CoderDojoMusashikosugi/cub_2026_timing_sync_if_board/plan/design.md

# GPSタイミング同期インターフェース基板 設計書

- 文書状態: 初回試作を2026-09-06に発注し、2026-10から実機で試験中 / 機構条件と実機検証結果待ち
- 更新日: 2026-10-17
- 文書版: 0.38
- 発注版の基板: 回路図・PCB図・BOMは[`../hardware/rev1/`](../hardware/rev1/)。外形・層数・テストパッドの面は本書の当初の設計値と違う（§7）
- 製造先: JLCPCB PCBA
- EDA: EasyEDA Pro
- 文書種別: 最終設計の正本。検討経緯は[`considerations.md`](./considerations.md)、現在の未解決事項は[`../hardware/overall/open_issues.md`](../hardware/overall/open_issues.md)に分離する
- 最新clock部品選定: [`../hardware/reviews/oi010_tcxo_selection.md`](../hardware/reviews/oi010_tcxo_selection.md)（U2/U14はDR-050、bias値はDR-053）
- メーカー一次資料: [`../hardware/datasheets/`](../hardware/datasheets/)

## 1. 目的

外部UM982モジュールを基準時刻源とし、PPSおよびNMEA時刻情報をJetson Orin Nano、VLP-32C、Mid-360、Spresense向けレベルシフト基板へ配信する。GNSS信号消失時はJetson、さらにJetsonが使用できない場合はYXC `OW7EL89CENUYO3YLC-24M` / C22434890の24 MHz TCXOをU14 comparatorでCMOS化したclockでholdoverし、CR2032で保持したSTM32内蔵RTCの暦を使ってPPS/NMEAの出力を継続する。

## 2. 確定要求

| ID | 要求 | 状態 |
|---|---|---|
| R-001 | UM982のPPS/NMEAを各接続機器へ配信する | 確定 |
| R-002 | VLP-32C向けUART信号は論理反転する | 確定 |
| R-003 | VLP-32C向けNMEAの時刻は、元の時刻に対して1秒進める | 確定 |
| R-004 | GNSS信号消失時、MCUからPPS/NMEAを出力できる | 確定 |
| R-005 | JLCPCB PCBAを使用し、低コストを優先する | 確定 |
| R-006 | Basic Parts / Promotional Partsを可能な限り優先する | 確定 |
| R-007 | UM982は外部モジュールとし、GHコネクタ経由でPPS/NMEAを入力する | 確定 |
| R-008 | Jetson Orin Nano公式Developer Kitの40-pin headerへ、別の中継基板を経由して接続する | 確定 |
| R-009 | Spresenseのレベルシフトは別基板で行い、本基板のスコープ外とする | 確定 |
| R-010 | Jetsonからデバッグ用時刻を受信し、基板時刻とRTCを初期化できる | 確定 |
| R-011 | 時刻源の優先順位をGNSS、Jetson、RTCの順とする | 確定 |
| R-012 | Jetsonがなくても妥当な日時で起動できるよう、バックアップ電源付きRTCを搭載する | 確定 |
| R-013 | GNSS消失後5分間の時刻誤差を1 ms以下とする | 確定 |
| R-014 | 基板電源はUSB Type-Cから供給する | 確定 |
| R-015 | USB Type-CをMCUのデバッグコンソールおよびファームウェア更新にも使用する | 確定 |
| R-016 | 外部UM982へ本基板から給電しない | 確定 |
| R-017 | Jetson、VLP-32C、Mid-360、Spresense向けTXをMCUから個別に制御する | 確定 |
| R-018 | MCUの個別UART TX/RXおよびPPSを配線した予備GHコネクタを2個設ける | 確定 |

## 3. インターフェース仕様

### 3.1 UM982

- 電源は3.0～3.6 V、標準3.3 V。代表動作電流180 mA、最大300 mA。
- I/Oは3.3 V系。出力条件は2 mA時にLow最大0.45 V、High最小 `VCC - 0.45 V`。
- 3 UARTと1 PPSを持つ。
- UM982自体は本基板へ実装せず、外部モジュールからPPS/NMEA/GNDをGHコネクタで受ける。
- 現在の前提ではUM982への電源供給は行わない。給電も必要な場合はコネクタと電源回路を変更する。

資料: [UM982 User Manual R1.7](https://www.unicorecomm.com/assets/UM982_User_Manual_R1.7/index.html)

### 3.2 VLP-32C

- GPS入力はPPSと、NMEA GPRMCまたはGPGGAを使用する。
- 入力Highは3.0 V超～5.0 V未満、Lowは1.2 V未満。High時に2 mA以上を供給できること。
- UARTから直接出した通常極性ではなく、反転したシリアル信号を要求する。
- NMEA完了から次のPPS立上りまで300 ms以上、PPS立下りから次のNMEA開始まで50 ms以上が必要。
- したがって、VLP-32C向けNMEAは次のPPSに対応するUTC時刻へ+1秒し、チェックサムも再計算する。

資料: [VLP-32C User Manual](https://data.ouster.io/downloads/velodyne/user-manual/vlp-32c-revd-user-manual.pdf)

### 3.3 Mid-360

- PPSとGPRMC/GNRMCによるGPS同期に対応する。
- UART同期時は3.3 V TTLを使用し、PPSはMid-360のpin 8、GPS UART入力はpin 10。
- UARTは9600 baud、8 data bits、no parity。GPRMCまたはGNRMCを含める。
- PPS立上り後0～900 msにNMEA送信開始、推奨は0～430 ms。PPS High幅は10～200 ms推奨。
- PPSの立上りスルーレートは1 V/us超を推奨。

資料: [Livox Mid-360 Time Synchronization Instructions](https://livox-wiki-en.readthedocs.io/en/latest/tutorials/new_product/common/time_sync.html)

### 3.4 Jetson Orin Nano

- J3は別の中継基板へ接続し、中継基板が公式Developer Kit (P3768 carrier) の40-pin expansion headerへ配線する。どのheader pinへつなぐかは中継基板の範囲とし、本書では定めない（DR-062）。
- J3は出力専用とし、pin 2からPPS、pin 3からNMEA（GPRMC、9600 baud、8N1。§4.2）を出す。全信号は3.3 V系。J3 pin 4の受信回路は残るが運用では使わない（DR-061）。
- 時刻設定・状態確認の双方向通信はUSB（J1）のCDC interface 2で行う。CRC付きframe仕様は[`../hardware/overall/jetson_time_protocol.md`](../hardware/overall/jetson_time_protocol.md)を正とする（DR-061）。
- 参考: 2026-10時点のCub_ROS（Cub4）では、Jetson側はPPSをpin 32（GPIO07、`/dev/pps1`）、NMEAをpin 10（`/dev/ttyTHS1`、9600 baud）でNTPsecへ入れる設定である（Cub_ROS `scripts/install_host_settings.sh`）。

資料: [Jetson Orin Nano Developer Kit Carrier Board Specification](https://developer.nvidia.com/downloads/assets/embedded/secure/jetson/orin_nano/docs/jetson_orin_nano_devkit_carrier_board_specification_sp.pdf)

### 3.5 Spresense

- Spresense main boardのUARTは1.8 Vであるため、レベル変換は別プロジェクトの基板で行う。
- 本基板は外部レベルシフト基板へ3.3 V PPS/NMEA/GNDを出力する。Spresense本体へ直接接続しない。

資料: [Spresense Hardware Documents](https://developer.spresense.sony-semicon.com/development-guides/?lang=en&page=hw_docs)

## 4. システム構成

```mermaid
flowchart LR
    UM[UM982] -->|reference PPS| MCU[MCU timer + DPLL/holdover]
    USB[USB Type-C power + USB 2.0] --> MCU
    TCXO[YXC C22434890 24 MHz clipped sine] --> CMP[TI C544337 CMOS comparator]
    CMP -->|R8 / HSE bypass / timer clock| MCU
    LSE[LSE crystal + CR2032] -->|internal RTC / calendar| MCU
    UM -->|NMEA UART| MCU
    MCU -->|continuous generated PPS| FAN[PPS fanout / output buffers]
    FAN --> JET[Jetson]
    FAN --> VLP[VLP-32C]
    FAN --> MID[Mid-360]
    FAN --> SPR[Spresense]
    JET <-->|USB CDC: time set / status| USB
    MCU -->|dedicated UART| JBUF[Jetson output buffer]
    JBUF --> JET
    MCU -->|dedicated UART| MBUF[Mid output buffer]
    MBUF --> MID
    MCU -->|dedicated UART| SBUF[Spresense output buffer]
    SBUF --> SPR
    MCU -->|UTC + 1 s, checksum recomputed / TXINV| INV[3.3 V VLP buffer]
    INV --> VLP
```

### 4.1 PPS経路

- 出力PPSはGNSS正常時を含め、常にMCUのハードウェアタイマー出力比較機能で生成する。GNSS PPSは出力源として直接切り替えず、MCUタイマーを規律する基準として使用する。
- 生成PPSとGNSS PPSキャプチャは32-bitのTIM2へ集約する。生成PPSはPC5/TIM2_CH2、GNSS PPSキャプチャはPA5/TIM2_CH1を使用し、CH3のpinは未使用とする（firmwareはCH3/CH4をpinなしの比較割込みに使う）。16-bitのTIM3は1 Hz生成に必要な分解能が不足するため使用しない。詳細は[`../hardware/overall/pin_assignment.md`](../hardware/overall/pin_assignment.md)の「PPS/holdoverのtimer構成」を正とする。
- MCUはGNSS PPSをタイマー入力キャプチャで監視し、位相誤差と周波数誤差を推定する。GNSS PPSはU4A `SN74LV14A`で反転するため立下りedgeでキャプチャする。
- GNSS異常時はPPS生成を継続し、GNSS有効中に学習した24 MHz TCXOの周波数補正値を保持する。TCXOはTIM2のクロック源そのものなので、外部RTCとの周波数比計測は不要である。
- U2はYXC `OW7EL89CENUYO3YLC-24M` / C22434890を採用する。3.3 V、clipped sine 0.8 Vp-p min、10 kOhm // 10 pF、-30～85 ℃で温度安定度±1.5 ppm、消費電流2.0 mA maxである。C11でAC結合して1.031 Vへbiasし、U14 TI `LMV7219M7X/NOPB` / C544337で3.3 V CMOS化する。U14 OUTをR8経由でPF0/OSC_INへ入力し、STM32はHSE bypass mode、PF1/OSC_OUTは未接続とする。PF0入力は24 MHz、duty 45～55 %を満たすことを試作合否条件とする。
- GNSS復帰時は正常なPPS/NMEAを5回以上連続受信してから再同期を開始する。出力PPS周期の補正量を1秒当たり±100 usに制限し、PPS間隔を0.999900～1.000100秒の範囲で緩やかにGNSS位相へ戻す。
- 再同期中も短パルス、二重パルス、パルス欠落、秒の重複・飛越を発生させない。位相差が通常のslewで安全に回復できないほど大きい場合は、次のとおり扱う（DR-061）。holdover中の時刻がGNSS由来なら、位相差100 ms超または秒の不一致で`FAULT`（全出力High-Z）とする。RTCまたはJetson由来なら、1 ms超または秒の不一致で出力をHigh-Zにしてstepし、2秒正常が続いてから出力を戻す。詳細は[`../hardware/overall/time_source_state_machine.md`](../hardware/overall/time_source_state_machine.md)「GNSS復帰時の合わせ方」。
- 各PPS出力には個別の直列抵抗を設ける。測定は原則として各コネクタpin 2とpin 1 GNDから行い、信号測定用の恒久テストパッドは生成源`PPS_GENERATED`のTP6、VLP負荷試験用TP7/TP8、PA6の汎用firmware trace用TP9だけとする。初回プロトタイプではGH信号ESD footprint自体を設けず、同一ロボット内・電源OFF中のみ接続という運用条件を適用する。

#### 4.1.1 GNSS PPSに対する遅延・位相差

- 現構成は、受信したGNSS PPSの同じedgeを遅延させて出力するrepeaterではない。DPLLで次の秒境界を予測し、MCU timerが出力PPSを生成する。
- したがって定常時に管理する値は「入力から出力までの因果的な伝搬遅延」ではなく、「GNSS PPSと生成PPSの位相差」とする。
- GNSS入力はU4A `SN74LV14A`を通るため信号が反転する。3.3 V・CL=15 pFでの伝搬遅延は最大15 ns（-40～85 ℃）であり、固定offsetは出力74LVC125Aと合わせて実測・校正する。
- 入力側の固定遅延にはR13 4.7 kOhm、U4A入力容量2.3 pF、配線・source容量、U4A伝搬遅延、capture同期遅延が含まれる。旧74HC14を前提にした55～82 ns/基板間差27 nsの概算は使用せず、実装後の測定値をDPLL位相補正へ含める。
- STM32G0B1で32-bitのTIM2を48 MHzで動作させた場合の1 tickは約20.833 ns。ARR=47,999,999で1秒周期とし、周期補正の1 LSBは約0.0208 ppmとなる。入力capture同期遅延を含む固定offsetは、実装後に測定してDPLLの位相補正値へ含める。
- timer output compareでedgeを生成するため、通常のfirmware割込み応答時間はPPS edgeのジッタへ直接加算されない。
- 設計目標は、GNSS追従安定後の基板コネクタ出力edgeをGNSS入力edgeに対して絶対値1 us以内とする。保証可否は基準クロック構成と実機測定後に判定する。
- 電源投入後は、最初に生成PPSをGNSS PPSへstepで揃えてから、位相差1 us以内のGNSS PPS/NMEAを5回連続確認してPPSを有効化する。屋外の実測では、PPSとRMC=`A`がそろってから約8秒だった。GNSS復帰時は、slewで戻せる範囲（§4.1）なら既存PPSを停止せず、±100 us/秒以内で位相を戻す。
- ケーブルの伝搬時間は基板コネクタより後段の遅延として別管理する。接続先での同期精度を規定する場合はケーブル長差も校正対象とする。

### 4.2 NMEA経路

- UM982のNMEAをMCUで受信し、構文、UTC、valid flag、チェックサムを検証する。
- Jetson、Mid-360、Spresense、VLP-32C、予備1、予備2はそれぞれ別のMCU UART/LPUART TXへ割り当てる。TX線同士を電気的に分岐せず、送信内容、baud rate、送信開始時刻、出力enableを個別に制御する。
- Mid-360とSpresenseへは当初同じGPRMC/GNRMCを9600 baud / 8N1 / 1 Hzで送るが、ファームウェア上は独立した送信queueを持たせる。
- VLP-32C系はUTCを1秒加算し、23:59:59の日付繰上げも処理してチェックサムを再計算した後、論理反転して出力する。
- GNSS異常時は保持時刻を同じ出力経路へ載せ、RMCのstatusは無効（`V`）とする。保持中の時刻継続とGNSS測位有効性を混同させない。
- VLP-32C/Mid-360がRMC=`V`で内部同期を維持することはメーカー資料で保証されない。試作ではPPS/RMC=`V`を継続し、各LiDARのtimestamp追従を統合試験する。`A`を偽装しない。

### 4.3 電源

- 入力VBUSはUSB規定内の4.75～5.25 Vとする。MCU、U2 TCXO、U14 comparator、全出力bufferは3.3 Vとし、TCXO専用LDOは設けない。VLP専用電源も設けない。
- USB Type-CのVBUS 5 Vだけを主電源とする。Jetson用GHおよび他の信号コネクタからは給電しない。
- USB Type-CはUSB 2.0 device/UFPとして構成し、CC1/CC2へ各5.1 kOhmのRdを接続する。USB PDは実装しない。
- VBUSの500 mA級リセッタブルヒューズF1は低予算初回ではDNPとし、F1と並列のR3 `0603WAF0000T5E` / C21189を実装してVBUSを導通させる。D1はPromotionalの単方向TVS `SMF6.0A` / C19077499を初回から実装し、pin 1(K)を`VBUS_PROTECTED`、pin 2(A)をGNDへ接続する。保護variantではR3をDNP、F1を実装し、F1/R3の同時実装は禁止する。D1はVRWM 6 V、VBR 6.67～7.37 V、VC max 10.3 VのESD・短時間transient対策であり、継続的な過電圧を遮断するOVPではない。
- 外部機器へ給電しない。通常構成の基板消費電流はUSB 2.0未configured時の100 mA未満を合否基準とする。
- VBUS配線・R3・F1の物理設計上限は0.5 Aとするが、これは通常消費の許容値ではない。電流内訳、U3損失、VBAT寿命は[`../hardware/overall/power_budget.md`](../hardware/overall/power_budget.md)を正とする。
- CR2032からR4=100 Ohmを介してSTM32のVBATへ接続し、LSEと内蔵RTCにより主電源断中も暦とbackup registerを保持する。充電経路は設けない。
- 外部UM982、LiDAR、Jetson、Spresenseへは原則として給電せず、信号と共通GNDだけを接続する。
- 初回試作では追加のpower sense/isolationを実装しない。J2～J8は全機器OFF中に接続・切断し、本基板を外部入力源より先または同時にONする。接続先OFF前に全出力`OE_N`をHighとしてHigh-Zへ移行する。詳細は[`../hardware/overall/pin_assignment.md`](../hardware/overall/pin_assignment.md)の「試作機の電源順序制約」を正とする。

### 4.4 時刻源の優先順位と更新

| 優先度 | 時刻源 | 有効条件 | 動作 |
|---:|---|---|---|
| 1 | GNSS | 正常なPPSと検証済みNMEAを継続受信 | TCXO/TIM2 PPSをGNSSへ規律し、MCU時刻と内蔵RTCを更新 |
| 2 | Jetson | GNSS無効かつJetsonから有効な時刻設定/更新を受信 | MCU時刻と内蔵RTCを更新し、TCXO/TIM2生成PPS/NMEAを使用 |
| 3 | 内蔵RTC + TCXO holdover | GNSSとJetsonが無効 | 内蔵RTCの暦とTCXO/TIM2の秒間隔でPPS/NMEAを使用 |

- Jetsonの一回限りのSETコマンドはRTC初期化として扱う。
- Jetsonを継続時刻源として扱う場合は、時刻更新の有効期限を設け、timeout後はRTCへ戻る。（現在のfirmwareには有効期限がない。[`../firmware/test_plan.md`](../firmware/test_plan.md) P-13）
- GNSS有効中はJetsonからのSETを拒否するか、RTCを変更せずデバッグ応答だけを返す。（現在のfirmwareは`NACK_GNSS_ACTIVE`で拒否する）
- 現在使用中の時刻源、最終同期時刻、PPS/NMEA状態、RTC有効性をJetsonから取得できるプロトコルを定義する。現在のfirmwareの`TIME_STATUS`が返すのは、UTC、state、flags（RTC有効、GNSS有効、clock fault、LSE ready）、最後に適用したSETのsource_id/sequence、last errorである。時刻源、最終同期時刻、出力のenable状態は返さず、consoleの`status`でだけ見られる。RTC有効性は使用する全backup registerのsignature/versionとpayload CRC、RTC-domain configuration CRC、`INITS`、RTCSEL/LSEON/LSERDY/RTCEN、calendar範囲、SSR単調性で判定し、VBAT電圧の実測値とはしない。`RTC_VALID`は起動時の整合性だけを示し、主電源断中のLSE連続動作や電池残量は保証しない。
- 内蔵RTC/LSEの起動判定、Jetson SETのstep/slew、GNSS復帰、clock fault処理の正本は[`../hardware/overall/time_source_state_machine.md`](../hardware/overall/time_source_state_machine.md)とする。

### 4.5 USBデバッグインターフェース

- MCUのnative USB Full-Speed deviceをUSB Type-CのD+/D-へ接続する。
- 通常動作時はUSB CDC ACMを2つ実装する。interface 0はconsoleとしてログ表示、状態取得、テスト出力制御に使い、interface 2はJetsonとの時刻protocol（§3.4）に使う。
- 内蔵system bootloaderのUSB DFUでファームウェアを書き込めるよう、BOOT操作とRESET操作を基板上で可能にする。
- ファームウェア異常時のsource-level debugに備え、SWDIO、SWCLK、NRST、3V3、GNDのテストパッドを残す。
- PA6には唯一の汎用firmware event traceとしてTP9 `TP_FW_TRACE`を残す。SWOではなくGPIO pulse観測用とし、通常firmwareではanalog/no-pull、明示的なdebug buildまたは設定時だけ既定LowのGPIO出力として有効化する。製品機能はTP9へ依存させない。
- D+/D-はU11 `USBLC6-2SC6`で保護し、差動配線を短く等長にする。発注版に直列抵抗はない（U11とMCUを直結）。
- SW1 RESETとSW2 BOOTには小型Basic `TS-1088-AR02016` / C720477を使用する。PA15の専用DFU buttonおよび予備test padは設けずNCとし、正常時はUSB CDC command、異常時はBOOT+RESETでDFUへ入る設計である。
- PA14-BOOT0は100 kOhm pull-down、BOOT switch側は1 kOhm seriesとする。NRSTは10 kOhm pull-up、100 nF to GNDとする。
- 外部BOOT0を使うoption byte（`nBOOT_SEL=0`）は、試験中の2枚では設定していない（出荷時のまま）。このためSW2+SW1ではDFUに入れず、DFUへはconsoleの`dfu` commandで移る。未書込みの基板はUSBをつなぐだけでDFUになる。option byteを設定するかは判断待ちである（[`../firmware/test_plan.md`](../firmware/test_plan.md) P-22）。
- SWD debug接続後にBOOT+RESETでDFUへ入る場合は、STM32G0B1 errata ES0548 §2.2.8に従い、probeを外してUSBを含む全主電源を完全power cycleしてから操作する。

### 4.6 GH互換コネクタ割当

基板側はGH互換のCJT A1257シリーズ 1.25 mm pitch横型SMTヘッダとし、3 pinは`A1257WR-S-3P` / `C225126`、4 pinは`A1257WR-S-4P` / `C225127`を採用する。相手側は`A1257H-3P` / `A1257H-4P`、圧着端子は`A1257-TP`へ統一する。誤挿入を避けるため、信号コネクタのpin 1はすべてGNDとする。選定根拠は[`../hardware/reviews/gh_connector_selection.md`](../hardware/reviews/gh_connector_selection.md)に保存する。

| Ref | 接続先 | 極数 | pin assignment |
|---|---|---:|---|
| J1 | USB Type-C | USB2 Type-C | VBUS, GND, `USB_DP_CONN`, `USB_DN_CONN`, CC1, CC2 |
| J2 | 外部UM982 | 3 | 1:GND, 2:`GNSS_PPS_IN`, 3:`GNSS_NMEA_RX_IN` |
| J3 | Jetson（中継基板経由） | 4 | 1:GND, 2:`JETSON_PPS_OUT`, 3:`JETSON_TX_OUT`, 4:`JETSON_RX_IN` |
| J4 | VLP-32C | 3 | 1:GND, 2:`VLP_PPS_OUT`, 3:`VLP_TX_OUT` |
| J5 | Mid-360 | 3 | 1:GND, 2:`MID360_PPS_OUT`, 3:`MID360_TX_OUT` |
| J6 | Spresense IMU用レベルシフト基板 | 3 | 1:GND, 2:`IMU_PPS_OUT`, 3:`IMU_TX_OUT` |
| J7 | 予備UART 1 | 4 | 1:GND, 2:`AUX1_PPS_OUT`, 3:`AUX1_TX_OUT`, 4:`AUX1_RX_IN` |
| J8 | 予備UART 2 | 4 | 1:GND, 2:`AUX2_PPS_OUT`, 3:`AUX2_TX_OUT`, 4:`AUX2_RX_IN` |

J2/J3/J7/J8の入力ラベルは直列抵抗よりU4側に置き、コネクタから直列抵抗までの短い区間は無名netとする。USBはU11を境にコネクタ側`USB_DP_CONN`/`USB_DN_CONN`とMCU側`USB_DP`/`USB_DN`へ分割し、保護素子を経由する配線を固定する。

- J3の相手は別の中継基板とし、Jetson 40-pin headerへの配線とpin割当は中継基板で管理する（DR-062）。J3 pin 4は運用では使わない（§3.4）。
- 本基板をJetson側40-pin headerへ直接搭載しない。中継基板とはGHケーブルで接続する。
- J7/J8は3.3 V UART専用とし、電源pinを設けない。外部機器への給電が必要になった場合は別コネクタまたは別基板で対応する。
- J2～J8はCJT A1257シリーズをJLCPCBでPCBA実装する（初回試作はこの構成で実装した）。
- 相手機器側connector/pin、使用UART、線色、線長はTBDとし、試作ハーネス製作前に[`../hardware/overall/harness_pinout.md`](../hardware/overall/harness_pinout.md)のTODOと導通検査表を完成させる。TBDを推測で埋めない。

## 5. 信号表

| 接続先 | PPS | NMEA | 電気レベル | 固有処理 | 状態 |
|---|---:|---:|---|---|---|
| Jetson Orin Nano（中継基板経由） | 1 | 1 | 3.3 V | J3は出力専用。時刻設定・状態確認はUSB CDC interface 2 | 基本仕様確定 |
| VLP-32C | 1 | 1 | 3.3 V試作出力 | NMEA +1秒、UART反転。High >3.0 V @ 2 mAはJ4実測で合否判定 | 機能・GH互換3 pin確定、電圧は試作検証 |
| Mid-360 | 1 | 1 | 3.3 V TTL | 9600 8N1、GPRMC/GNRMC | 電気仕様・GH互換3 pin確定 |
| Spresense IMU用レベルシフト基板 | 1 | 1 | 3.3 V | `IMU_*`はCXD5602PWBIMU1J向け系統名。レベル変換はスコープ外 | 基本仕様確定 |
| 予備UART 1 | 1 | 双方向UART 1 | 3.3 V | 独立TX/RX、給電なし | 確定 |
| 予備UART 2 | 1 | 双方向UART 1 | 3.3 V | 独立TX/RX、給電なし | 確定 |

## 6. MCUおよび主要回路

### 6.1 MCUへ割り当てる機能

- UM982受信用UART x1。
- Jetson、VLP-32C、Mid-360、Spresense、予備2系統の独立TX、合計6系統。
- Jetsonと予備2系統のRX、UM982受信用RX。Jetson RX（J3 pin 4）は運用では使わず、受信経路と折返しの試験（UA-01、UA-03）だけに使う（DR-061）。
- Jetsonとの時刻protocol用のUSB CDC（§4.5）。
- VLP-32C用UARTはUSARTの`TXINV`で反転する。
- PPS入力キャプチャとPPS生成を1個の32-bitタイマー（TIM2）の2チャネルで実現する。
- UTC日時処理、NMEA parser/checksum、ウォッチドッグ、brown-out reset。（現在のfirmwareはwatchdogを使っておらず、BORのoption byteも変更していない。P-14）
- J7/J8のRX（予備UARTの受信）は回路にはあるが、現在の製品firmwareでは使っていない。
- 製造時書込み用SWD等。
- 24 MHz HSE bypass、内蔵RTC/LSE、backup register、smooth calibrationを使用する。

### 6.1.1 クロック構成

基板にはU2 YXC `OW7EL89CENUYO3YLC-24M` / C22434890、U14 TI `LMV7219M7X/NOPB` / C544337、32.768 kHz LSE水晶を実装する。U2のclipped-sine出力はC11と1.031 V bias回路を経てU14で3.3 V CMOS化し、R8経由でHSE bypass/PLL/TIM2を駆動する。LSEはCR2032でバックアップされるSTM32内蔵RTC専用とする。旧C48677994/C51822852/C51966238は採用解除した。

clock初期化は電源投入後5 ms以上待ち、Voltage Range 1へ設定して`VOSF=0`を確認し、Flash latencyを2 wait stateへ上げた後にPLLM=2、PLLN=16、PLLR=4のPLLへSYSCLKを切り替える。PLLQ=4をUSBへ供給する。LSEは`LSEDRV=10`（medium-high）とし、VBAT保持と競合するSTM32G0B1 errata ES0548 §2.2.1を避けるため`LSECSSON=0`とする。

| 項目 | 構成 | 備考 |
|---|---|---|
| SYSCLK / timer clock源 | 24 MHz TCXO + comparator + HSE bypass + PLL、48 MHz | PLLM=2、PLLN=16、PLLR=4。PF0 duty 45～55 %、Voltage Range 1、Flash 2 wait state。TIM2も48 MHz |
| timer clockの周波数基準 | **YXC OW7EL89CENUYO3YLC-24M / C22434890、温度安定度±1.5 ppm** | GNSS有効中に実測補正値を学習し、holdoverで保持する。U14の固定delayは周波数へ累積しない。R-013は試作実測で判定する |
| UTCの絶対基準 | GNSS PPS + 検証済みNMEA | GNSS有効中はDPLLで位相・周波数を規律する |
| USB clock | PLLQ=48 MHz | PLLM=2、PLLN=16、PLLQ=4。HSI48+CRSは使用しない |
| UART baud生成 | TCXO/PLL由来 | 温度安定度±1.5 ppm級であり、外部比率計測なしで十分なbaud精度を得る |
| RTC/calendar | STM32内蔵RTC + 32.768 kHz LSE + CR2032 | PC14/PC15に7 pF品を接続。`LSEDRV=10`、LSE CSS無効。電源断中はcalendar/backup registerを保持する |
| clock fault | HSE CSS + firmware監視 | HSE/PLL fault時はHSIへ退避するが、PPS/NMEAはHigh-Zとして`FAULT_CLOCK`へ遷移する |

以下の主要部品を採用し、初回試作に実装した。選定経緯は[`considerations.md`](./considerations.md)へ分離する。価格・在庫は2026-09-06の発注時点の値であり、次版の発注時に再確認する。

### 6.2 採用主要部品

| 機能 | 採用品 | LCSC | 選定理由 | 状態 |
|---|---|---|---|---|
| MCU | **STM32G0B1RCT6** | **C3034735** | native USB FS、6 USART + 2 LPUART、32-bit TIM2、LQFP-64、Flash 256 KB / SRAM 144 KB | **採用（DR-060、2026-09-06）。** 旧`STM32G0B1RBT6` / `C5143679`が在庫0となったため変更。2026-09-06確認時$3.0669、在庫173、予約可能104。**N接尾辞品`STM32G0B1RCT6N`はpin 40/41が非互換なので差し替え禁止** |
| TCXO | **YXC OW7EL89CENUYO3YLC-24M** | **C22434890** | 24 MHz、clipped sine 0.8 Vp-p min、±1.5 ppm、-30～85 ℃、2.0 mA max、SMD2016-4P | **採用。** 通常SMT、在庫約6,500、$0.87前後。無断代替禁止 |
| Clock comparator | **TI LMV7219M7X/NOPB** | **C544337** | 2.7～5 V、push-pull、7 mV hysteresis、20 ns max delay、SC-70-5 | **採用。** API確認時在庫911、予約可能907、$0.8965 |
| LSE crystal | SC-32S32.768kHz20PPM7pF | C97604 | 32.768 kHz、CL=7 pF、±20 ppm、SMD3215 | 採用。内蔵RTC/calendar専用。2026-08-12 API価格$0.1886 |
| USB ESD | USBLC6-2SC6 | C7519 | USB 2.0対応2-line ESD保護 | 採用。D+/D-コネクタ直近へ実装 |

- U2はpin 1=NC、pin 2=GND、pin 3=OUT、pin 4=`3V3`。U14はpin 1=OUT、2=GND、3=+IN、4=-IN、5=`3V3`とする。C11 AC結合、R5=33 kOhm/R6=15 kOhm/C12の1.031 V reference、R7 bias、C13 decouplingを実装し、U14 pin 1をR8=33 Ohm経由でPF0へ接続する。U15/`+2V8_CLK`は配置しない。
- C22434890は通常SMT、C544337はExtended/SMTである。DR-050時点の受動部品とclock直列Rを含むclock chainは約$1.8346だった。
- JLCPCBのBasic/Promotional区分は変動するため、次版の発注用BOM作成時に公式parts libraryで再確認する。
- STM32G0B1RCT6は[ST製品情報](https://www.st.com/en/microcontrollers-microprocessors/stm32g0b1rc.html)、データシート`STM32G0B1xB/xC/xE` DS13560 Rev 6および[JLCPCB C3034735](https://jlcpcb.com/partdetail/STMicroelectronics-STM32G0B1RCT6/C3034735)、U2/U14は[YXC YSO510TP family資料](https://www.yxc.hk/uploadfiles/2023/07/20230710175706329.pdf)と[TI LMV7219資料](https://www.ti.com/lit/ds/symlink/lmv7219.pdf)を参照。選定詳細は[`../hardware/reviews/oi010_tcxo_selection.md`](../hardware/reviews/oi010_tcxo_selection.md)を正とする。MCUの在庫切れ対応と代替検証は[`../hardware/reviews/mcu_stock_alternative_20260906.md`](../hardware/reviews/mcu_stock_alternative_20260906.md)を正とする。
- MCUの`_RB` / `_RC` / `_RE`はDS13560 Rev 6 Table 2で同一列にまとめられ、`VDDIO2 pin / VSS pin = No/No`、GPIO 60、USART 6、LPUART 2、USB 1、32-bit timer 1が共通である。差はFlash容量だけ（128 / 256 / 512 KB）でSRAMはいずれも144 KB。LQFP64のpinout図も1枚しかない。EasyEDAのpackageも旧新ともuuid `2afd511af2e94adea785d3da1efd72a1`（`LQFP-64_L10.0-W10.0-P0.50-LS12.0-BL`）で同一実体であり、**PCBのpad・配線・部品配置およびpin割当は変更しない。** firmware側はlinker scriptのFLASH容量と、Flash容量で変わるdual bankの境界・ページ番号（RM0444）だけ確認する。

### 6.3 MCUピン割当

`STM32G0B1RCT6` LQFP-64へ再割当済みであり、物理pin番号、alternate function、net、connector/buffer接続の正本は[`../hardware/overall/pin_assignment.md`](../hardware/overall/pin_assignment.md)とする。旧LQFP-48のpin番号は使用しない。

2026-08-11のDR-012で、物理pin番号をST CubeMX pin database（`STM32G0B1R(B-C-E)Tx.xml`、`Package="LQFP64"`）へ照合し全面修正した。**版0.20以前のpin番号表は使用してはならない。** GPIO名とAF番号は修正前から正しい。

- 6系統TXはUSART1/2/4/5/6およびLPUART2へ分離する。
- GNSS PPS captureはPA5/TIM2_CH1（物理pin 22）、生成PPSはPC5/TIM2_CH2（物理pin 26）を使用する。TIM3は16-bitで1 Hz生成に使えないため用途から外した。
- TCXO clockはPF0/OSC_IN（物理pin 10）へHSE bypass入力し、PF1/OSC_OUTは未接続とする。LSEはPC14/PC15（物理pin 4/5）へ接続する。PB10/TIM2_CH3は未使用とする。
- SC-32SのESR最大70 kOhm、C0 typ 1 pF、CL 7 pFから`gmcrit`は概算0.76 uA/Vであり、STM32のmedium-low最大0.75 uA/Vでは余裕がないためmedium-high（`LSEDRV=10`、最大1.7 uA/V）を固定使用する。
- USBはdefault mappingのPA11/PA12を使用し、PA9/PA10へのUSB remapは使用しない。
- **本パッケージの電源・基準pinはVBAT（6）、VREF+（7）、VDD（8）、VSS（9）の4本だけである。`VDDIO2`、`VDDA`、`VSSA`、`VDDUSB`のpinは存在しない。** pin 40/41はPD8/PD9であり、電源へ接続してはならない。
- `PPS_OE_N`はMCUが時刻源とtimer初期化を検証するまでHighに保持し、全PPS出力を無効にする。
- PA14はSWCLKとBOOT0を兼ねるため、通常動作を妨げない抵抗構成でBOOT操作する。

### 6.4 ロジック回路の採用構成

| ブロック | 構成 | 設計意図 |
|---|---|---|
| 外部入力 | TI `SN74LV14ADR` / C475503 hex inverting Schmitt x1 | GNSS PPS/NMEA、Jetson、予備UART x2の5入力を集約。UART `RXINV`とtimer edge極性で反転補償。GNSS PPSは100 kOhm pull-down、UART RXは100 kOhm pull-up |
| 3.3 V PPS/UART出力 | 74LVC125A quad buffer x3 | J3～J8の12出力を個別駆動・個別enable。U7C/U7DはVLP PPS/NMEAを担当 |
| VLP PPS/NMEA出力 | U7C/U7D `74LVC125A` | 3.3 V試作出力。High >3.0 V @ 2 mAは1.5 kOhm負荷とVLP実機で検証 |
| VLP反転 | STM32 USART `TXINV` + U7D | VLP-32C要求の反転UARTをMCU内で生成。専用電源・level driverは使用しない |

出力bufferはU7=J3/J4、U8=J5/J6、U12=J7/J8を担当し、すべて3.3 Vで駆動する。PPSは入力netだけを共通化し、6出力は個別buffer出力とする。channel、net、`/OE`、connector pinの完全な対応は[`../hardware/overall/pin_assignment.md`](../hardware/overall/pin_assignment.md)を正とする。

- U4 `SN74LV14A`は`Ioff`に対応し、VCC=0 V時の部分給電防止を規定している。4.7 kOhm直列抵抗と100 kOhm biasは入力保護・未接続時状態固定のため維持する。コネクタ側機器を含むシステム全体のhot-plug可否は別途評価し、U4単体の`Ioff`だけを根拠に無条件許可しない。
- `SN74LV14A`はVCC=3.3 VでVT+ max 2.31 V、VT- min 0.99 V、hysteresis min 0.33 Vを規定する。GNSS PPSの100 kOhm pull-down回路は外部High=2.85 V/Low=0.45 Vの保守条件でU4入力約2.72 V/0.43 V、UARTの100 kOhm pull-up回路は約2.87 V/0.58 Vとなり、保証しきい値に対して成立する。
- GHコネクタ直前の出力には33 Ohm初期値の直列抵抗を置く。**VLP出力の2 netだけは10 Ohmとする。** High >3.0 V @ 2 mAは、規定されていない条件を他の試験点から補間して保証値とみなさず、1.5 kOhm負荷とVLP実機で実力判定する。不合格の場合は次版で専用level driverを追加する。
- GH信号ESD footprintは初回基板から削除する。ノイズまたはESD問題が再現した場合は次版で必要なnetだけ再設計する。
- PPS source selectorは不要とし、MCUタイマー出力だけをPPS分配bufferへ入力する。GNSS復帰時の連続性はtimer/DPLL制御で確保する。

### 6.5 電源・USB回路の採用構成

| ブロック | 採用品 | 方針 |
|---|---|---|
| USB Type-C receptacle | TYPE-C-31-M-12相当、LCSC C165948 | USB 2.0 device、16 pin、CC1/CC2へ各5.1 kOhm Rd |
| 3.3 V LDO | TI `TPS70933DBVR`、LCSC C89347 | 逆電流保護内蔵、150 mA連続・200 mA peak、入力2.7～30 V、3.3 V固定、SOT-23-5。pin 1=IN、2=GND、3=EN、4=NC、5=OUT。IN/EN=`VBUS_PROTECTED`、OUT=`3V3`。3.3 V rail設計上限100 mA（DR-059） |
| USB ESD | USBLC6-2SC6、LCSC C7519 | D+/D-をコネクタ直近で保護 |
| VBUS保護 | F1 `MF-NSMF050-2` + R3 `0603WAF0000T5E` / C21189 + D1 `SMF6.0A` / C19077499 | 初回はF1 DNP、R3/D1実装。保護variantはF1/D1実装、R3 DNP。D1はPromotionalの単方向TVSでESD・短時間surge用。5 V規定USB電源のみ使用 |
| RTC backup | CR2032一次電池 + holder + R4 100 Ohm | 充電回路は設けず、BT1 pin 2（+）からR4を介してSTM32 VBATへ接続。pin 1（-）はGND（DR-058確認済み） |

- MCUのVDD/VDDAとVREF+は`3V3`へ接続し、VBATだけをCR2032由来の`VBAT_RTC`へ接続する。各電源pin直近へ100 nFを置く。VDDAはパッケージ内部でVDDへ結線されるため専用railは不要であり、旧`+3V3_A` netは廃止する。VREF+は`3V3`直結とし、VREFBUFは有効化しない。
- VBUS側bulkはC1=4.7 uF、3V3側bulkはC2/C3=各10 uFとする。R3の0 Ohmは突入電流を制限しない。
- TPS70933DBVRはVBUS=5.25 V・設計上限100 mAで0.195 Wを消費する。DBV packageのRthetaJA=212.1 ℃/Wから概算温度上昇は41.4 ℃であり、初回試作で実消費電流、3.3 V droop、U3表面温度を測定する。逆電流保護内蔵によりOI-012はDR-059で解決済みであり、USB切断・再投入時のrail波形は機能確認として継続する。
- USB `USB_DP_CONN`/`USB_DN_CONN`および`USB_DP`/`USB_DN`は90 Ohm differentialを目標に、同一層・短距離・連続GND参照で配線する。
- USB-Cからの給電とUSB通信を同一コネクタで行う。USB host機能、USB PD、外部機器へのVBUS配電は実装しない。
- SWDテストパッドはUSB CDC/DFUが動作しない状態からの復旧とリアルタイムデバッグ用であり、通常利用時はUSBだけで完結させる。

### 6.6 保持精度の成立条件

- 5分で1 msは平均周波数誤差3.33 ppm以下に相当する。

### 6.6.1 成立条件

**TIM2は温度安定度±1.5 ppmのC22434890をU14でCMOS化したclockを基準とする。GNSS校正時とholdover中の温度が異なる最悪条件ではpeak-to-peakの3.0 ppmを適用し、TCXO寄与は5分で0.900 msとする。U14の固定伝搬遅延は周期ごとに累積しない。公開仕様だけではR-013に十分なmarginがないため、試作実測で合否を判定する。**

GNSS有効中はPPSからTCXOの実偏差を推定し、TIM2のARR補正値として保存する。GNSS消失後は最後に検証済みの補正値を保持する。HSI16は起動・fault診断用であり、正常時のPPS時刻基準には使用しない。

### 6.6.2 誤差予算

| 要因 | 5分間の寄与 |
|---|---:|
| TCXO温度変化による周波数差（±1.5 ppmのpeak-to-peak） | 0.900 ms |
| TIM2周期補正量子化（48 MHz、1 count/sを300秒積算） | 約0.00625 ms |
| GNSS→holdover切替時の位相誤差、DPLL推定残差、入力固定offset校正残差、U14 jitter/delay変化 | 0.09375 ms以内 |

- ARR=47,999,999を公称値とし、1 count/秒の補正分解能は約0.0208 ppmである。
- C22434890の±1.5 ppmは-30～85 ℃に対する温度安定度であり、試作温度範囲0～40 ℃を包含する。初期偏差とagingはGNSS校正で除去し、温度安定度とは区別する。最悪仕様の残余marginは小さいため、0～40 ℃試験を省略しない。
- DPLL追従/再同期、入力buffer、timer capture、NMEA処理を含めた総誤差を実機で評価し、0～40 degCでGNSS消失後5分の誤差1 ms以下を合否条件とする。
- 内蔵RTC/LSEは電源断中の暦保持用であり、powered holdoverのサブms PPS基準には使用しない。電源断中の時刻精度はLSEの±20 ppm級となり、5分で約6 msが目安である。

### 6.7 JLCPCB向け原価低減ルール

1. 抵抗・コンデンサはユーザーが選定し、Basic Partsを優先する。BOMのR/C用MPN/C-codeは参考候補であり、設計条件と同等以上の互換品を許容する。標準ロジック・汎用レギュレータもBasic Partsを優先する。
2. MCU、コネクタ、発振器などBasicで揃いにくい部品は、Promotionalを先に比較する。
3. 役割が同じ部品の値・パッケージを統一し、ユニーク部品点数とExtended Partsの種類数を減らす。
4. 当初は0603中心とする方針だったが、初回試作の受動部品は0402が主体である（C1が0805、C2/C3・R3・D2が0603）。
5. 片面実装とし、信号品質とEMCを初回試作で評価する。当初は2層基板としていたが、初回試作は4層（Top、Inner1=GND全面、Inner2=信号とGND、Bottom=GND）で発注した。
6. 非R/C部品のLCSC品番、JLC区分、在庫、単価はBOM確定時に再確認し、設計書へ記録する。R/Cは特定品番の一致ではなく、値、許容差、定格、温度特性、package/footprintの互換性をレビューする。
7. 当初の外形は75 mm x 50 mmとしていたが、初回試作は60 mm x 38 mmで発注した。
8. 実装部品は表面だけに置き、Economic PCBAを維持する。test padは裏面へ置く方針だったが、初回試作ではTP1～TP9をすべて表面に置いた。
9. 面積だけを理由にBasic/安価なpackageからExtended/QFNへ変更しない。

次版の外形・層数を発注版に合わせるか当初の値へ戻すかは決めていない（[`../hardware/overall/open_issues.md`](../hardware/overall/open_issues.md) OI-016）。

## 7. 製造・運用前提

- 初回試作（2026-09-06発注）の基板は60 mm x 38 mm、角R3 mm、4層、片面実装で、取付穴はない。当初の設計値（75 mm x 50 mm、2層、test padは裏面）とは違う。発注版の回路図・PCB図・BOMは[`../hardware/rev1/`](../hardware/rev1/)にある。
- J2～J8は下の長辺に左から順に並べ、USB Type-Cは右の短辺に置いた。配置判断の根拠は[`../hardware/reviews/layout_area_cost_review.md`](../hardware/reviews/layout_area_cost_review.md)に保存する。レイアウト前に作った配置・配線ルール[`../hardware/overall/pcb_layout_guidelines.md`](../hardware/overall/pcb_layout_guidelines.md)は、外形・層数・test padの面などが発注版と違う。
- 予備connector J7/J8は要求R-018に基づき維持し、面積削減だけを理由に削除しない。
- `BS-CR2032-8` / `C7498149`ホルダは表面PCBA実装し、CR2032一次電池セルだけを後付けする。
- 機能上必要なExtended部品は許容する。初回試作はF1（PTC）だけDNPとし、D1（TVS）を含むその他の採用品はPCBA実装した。
- 初回試作の保証範囲は0～40 ℃、同一ロボット内、保守時のみ抜き差しとする。
- 回路図・PCB設計の正本はEasyEDA Proプロジェクトとする。
- 発注版の回路図netlistで、MCUの全pinの接続が[`../hardware/overall/pin_assignment.md`](../hardware/overall/pin_assignment.md)と一致することを確認した（2026-10）。
- UM982アンテナ接続・給電は本基板のスコープ外とする。
- GNSS追従中のPPS位相差は1 us以内を設計目標とし、実装後の校正・測定で保証可否を判定する。
- 相手機器側ハーネス、RTC有効性の外部報告形式、筐体への取付方法・最大高さは未確定である。テストパッドはDR-055でTP1～TP9へ確定し、TP9だけを汎用firmware trace用として残した。`RTC_VALID/INVALID`の内部判定条件はDR-034、U2/U14採用品番はDR-050で確定済みである。詳細と完了期限は[`../hardware/overall/open_issues.md`](../hardware/overall/open_issues.md)を正とする。

## 8. 検証・合否条件

- 各出力のHigh/Low電圧、立上り/立下り、PPS間チャネルスキュー。`PPS_GENERATED`はTP6、6系統のbuffer出力は測定用ハーネスで各コネクタpin 2（GND=pin 1）から測定する。
- J4 PPS/NMEAへ各1.5 kOhm負荷を接続し、High >3.0 V、Low <1.2 Vであること。PPSはTP7、NMEAはTP8、GNDはJ4 pin 1を使用する。VLP-32C実機でPPS lock、反転NMEA decode、UTC +1秒を確認する。
- VLP-32C入力での論理反転、NMEA完了～PPS立上り300 ms以上、PPS立下り～NMEA開始50 ms以上。
- Mid-360入力での3.3 Vレベル、PPS立上り後430 ms以内のNMEA開始。
- 23:59:59、月末、年末、うるう年でのVLP向け+1秒処理。
- NMEA checksum異常、部分受信、PPSのみ消失、NMEAのみ消失、完全消失。
- 0～40 ℃でGNSS消失後5分の時刻誤差が1 ms以下であること。24 MHz TCXO + U14をHSE bypass/TIM2クロック源とした構成で測定する（§6.6.1）。
- 0～40 ℃でU2 pin 3の振幅、U14入力common-mode、PF0入力の振幅・edge・duty・jitterを測定し、PF0 duty 45～55 %を満たすこと。Voltage Range 1、Flash 2 wait stateの順序を含むclock初期化とHSE CSS faultを確認する。
- 0～40 ℃でPLLQ=48 MHzを使用したUSB列挙を確認し、HSI48/CRSへ依存しないこと。
- LSE loopへ直列抵抗を挿入して安全係数`Sf = (RADD + ESR) / ESR`を測定し、0 ℃、40 ℃、CR2032単独給電で`Sf >= 3`を満たすこと。1 pF以下のprobeでOSC_IN側`Vpp`を測定し、`DL = ESR x (pi F Ctot)^2 x Vpp^2 / 2 < 0.5 uW`を満たすこと。
- 主電源OFF/ON、電池なし、`INITS=0`、application payload CRC異常、RTC-domain configuration CRC異常を注入し、ES0548 §2.2.11のBDRST sequence、RTC無効化、出力High-Zを確認する。LSE CSSは使用しない。
- GNSS追従中の出力PPS位相差が1 us以内であること。U4A入力経路の固定offsetを実測・校正した後に判定する。
- 最大動作時の3.3 V消費電流、電圧droop、U3の表面温度。
- J4接続前にVLP-32C側GPS入力端子の開放電圧を測定し、5 Vへのpull-upがないこと。
- holdover中にRMC=`V`を出力し、Mid-360/VLP-32Cのtimestamp追従可否を実機確認する。`A`を偽装しない。
- GNSSから保持時刻、保持時刻からGNSSへの切替時に短パルス、二重パルス、秒飛びがないこと。
- 文書化した電源順序で投入/切断し、外部機器OFF中に出力がHigh-Z、基板OFF中に外部入力が駆動されないこと。条件外のback-power試験は保護版検討時に行う。
- 通常firmwareでPA6がanalog/no-pullであること、debug有効時だけTP9が既定Lowから意図したevent pulseを出力すること。TP9を未接続としても全製品機能が成立すること。
