CoderDojoMusashikosugi/cub_2026_timing_sync_if_board/hardware/overall/pin_assignment.md

# MCU・信号割当

- 対象MCU: `STM32G0B1RCT6`、LQFP-64（DR-060で旧`STM32G0B1RBT6`から変更。**pin割当は一切変更なし**）
- 更新日: 2026-10-17（発注版との照合結果を反映。pin表の内容はDR-055のPA6 firmware trace pad、DR-053のclock bias値のまま変更なし）
- 発注版との照合: 2026-09-06に発注した基板の回路図netlist（[`../rev1/`](../rev1/)）で、MCU全pin、J2～J8、出力buffer 12 channel、U4のbiasが本書と一致することを確認した。ただし回路図ではnet名の付け方が一部違う。本書の`VBAT_RTC`、`VREF_CLK`、未使用pinの`NC_*`は回路図では無名のnetであり、`CLK_24M`はR8のU14側のnetで、R8のPF0側は無名である
- 状態: 2026-08-11にDR-012として物理pin番号を全面修正した。**旧版のpin 1～32および40～41は実物と不一致であり使用してはならない。** GPIO名とAF番号は旧版のまま正しい
- 根拠: **ST `STM32G0B1xB/xC/xE` datasheet DS13560 Rev 6 のFigure 8（GP版pinout）およびTable 12（LQFP64-GP列）** で全pin確認済み。補助としてCubeMX pin database `mcu/STM32G0B1R(B-C-E)Tx.xml`、ST生成pinctrlデータ（AF番号）、CMSISヘッダ`stm32g0b1xx.h`（timer bit幅）、KiCad symbol library
- **品種の固定: 本表はGP版（`_RxT`、N接尾辞なし）専用である。** N接尾辞品`STM32G0B1RCT6N`（`_RxTxN`）はpin 40/41が`VSS`/`VDDIO2`で、PD8/PD9が存在しない非互換pinoutである（DS13560 Figure 8、Table 2）。BOMのMPNをN接尾辞なしで固定し、差し替えない。本設計はUCPDを使用しないためGP版で不足はない
- **Flash容量違い品との互換: 本表は`STM32G0B1RBT6` / `STM32G0B1RCT6` / `STM32G0B1RET6`（LQFP-64、GP版）で共通に使える。** DS13560 Rev 6 Table 2は`_RB` / `_RC` / `_RE`を同一列にまとめ、`VDDIO2 pin / VSS pin = No/No`、GPIO 60、USART 6、LPUART 2、USB 1、32-bit timer 1を共通としている。LQFP64のpinout図もGP版1枚だけである。差はFlash容量（128 / 256 / 512 KB）のみでSRAMは144 KB共通。在庫都合でこの3品種間を移動してもpin割当・PCBは変更しない（DR-060、[`../reviews/mcu_stock_alternative_20260906.md`](../reviews/mcu_stock_alternative_20260906.md)）
- 最新レビュー: [`../reviews/pre_easyeda_design_review.md`](../reviews/pre_easyeda_design_review.md)
- 旧レビュー: [`../reviews/final_design_review.md`](../reviews/final_design_review.md)（pin番号照合の結論はDR-012で覆された）

2026-08-10にLQFP-48の`STM32G0B1CBT6`から変更した。旧LQFP-48のpin番号は使用せず、以下を製造用割当の正本とする。

本パッケージの電源・基準pinはVBAT（6）、VREF+（7）、VDD（8）、VSS（9）の4本だけである。**`VDDIO2`、`VDDA`、`VSSA`、`VDDUSB`のpinは存在しない。** pin 40/41はPD8/PD9であり、電源へ接続してはならない。

LQFP-64再割当へ適用した確定事項:

- GNSS PPS/NMEA、Jetson/AUX入力5回路はTI `SN74LV14ADR` / C475503 x1へ集約する。UART入力は各USARTの`RXINV`、PPS入力は反転edge captureを使う。各U4入力nodeには未接続時biasを設ける。
- 3.3 V PPS/UART出力の`74LVC125A`はU7/U8/U12の3個とし、J3～J8の全12出力を担当する。U7C/U7DをVLP-32CのPPS/NMEAへ使用する。
- VLP向け論理反転はUSARTの`TXINV`で行う。旧VLP専用U5/U6 driverと`+4V7_VLP`は使用しない。U2のclipped-sine出力はU14 comparatorで3.3 V CMOS化しPF0へ入力する。専用clock LDOは使用しない。
- VLP公式条件はHigh >3.0 Vかつ<5.0 V、Low <1.2 V、High時2 mA供給である。3.3 V `74LVC125A`にはこの組合せの直接min保証点がないため、J4を2 mA負荷で実測して試作合否を判定する。
- GH信号ESD footprintは設けない。通常出力は33 Ohm、VLPの2出力は10 Ohm、U4入力は4.7 kOhmを初期値とする。
- USB ESDとD1 TVSは実装し、F1 PTCは初回DNPとする。F1と並列のR3 `0603WAF0000T5E` / C21189を実装してVBUSを導通させる。
- DR-002対応として、`PPS_OE_N`はPB1、`IMU_TX_OE_N`はPB2へ割り当てる。PB1/PB2はDS13560 Table 12 note 4の条件付きreset pull-down対象外であり、reset中は外付け100 kOhm pull-upにより74LVC125AをHigh-Zへ固定する。
- DR-014対応として、生成PPSはPA6/TIM3_CH1ではなく**PC5/TIM2_CH2**から出力する。TIM3は16-bitで48 MHzから高分解能の1 Hzを生成できないため、32-bitのTIM2へ集約する。
- DR-018対応として、VREF+は`3V3`へ直結し100 nFを付ける。旧`+3V3_A`は廃止する。ADCを使用しないためアナログrailを分離しない。VREF+を外部駆動するのでVREFBUFは有効化しない。

## VBUS電源経路

```text
J1 VBUS -> VBUS_RAW -> (F1 || R3) -> VBUS_PROTECTED -> U3 / board loads
                                      |
                                      +-> D1 TVS -> GND
```

- F1=`MF-NSMF050-2`、R3=`0603WAF0000T5E` / C21189とし、同じ`VBUS_RAW`―`VBUS_PROTECTED`間へ並列接続する。R36は`IMU_TX_OE_N`の100 kOhm pull-upである。
- D1は単方向`SMF6.0A` / C19077499とし、pin 1 (K、band側)を`VBUS_PROTECTED`、pin 2 (A)をGNDへ接続する。初回variantからPCBA実装する。ESD・短時間surge用であり、継続的な過電圧を遮断するOVPではない。
- U11 `USBLC6-2SC6`はpin 1=`USB_DN_CONN`、2=GND、3=`USB_DP_CONN`、4=`USB_DP`、5=`VBUS_RAW`、6=`USB_DN`とする。ST datasheetの標準pin配置と第2回EasyEDA netlistで照合済みである。
- 初回variantはF1=DNP、R3=PCBA実装、D1=PCBA実装とする。
- 保護variantはF1=実装、R3=DNP、D1=PCBA実装とする。F1とR3を同時実装するとPTCがbypassされるため禁止する。
- R3は0 Ohm、抵抗50 mOhm未満、0603 jumper定格1 Aで、基板VBUS設計上限0.5 Aを満たす。0.5 A時の最大dropは25 mVとする。
- U3 `TPS70933DBVR` / C89347はpin 1=IN/`VBUS_PROTECTED`、2=GND、3=EN/`VBUS_PROTECTED`、4=NC、5=OUT/`3V3`とする。入力2.7～30 V、3.3 V固定、150 mA連続・200 mA peakで、逆電流保護を内蔵する。EN推奨上限6.5 Vに対しUSB 5 V接続で適合する（DR-059）。

## MCU割当

| Pin | GPIO | 機能 | Net | 接続先 |
|---:|---|---|---|---|
| 1 | PC11 | GPIO | `NC_PC11` | 未使用、回路図上NC |
| 2 | PC12 | GPIO | `NC_PC12` | 未使用、回路図上NC |
| 3 | PC13 | GPIO | `NC_PC13` | 未使用、回路図上NC。RTC_OUT/TAMPへ割り付けず、配線もLSE loopへ近づけない |
| 4 | PC14-OSC32_IN | LSE | `LSE_IN` | X1 SC-32S、C14 load capacitor |
| 5 | PC15-OSC32_OUT | LSE | `LSE_OUT` | X1 SC-32S、C15 load capacitor |
| 6 | VBAT | Power | `VBAT_RTC` | BT1 pin 2（CR2032正極）からR4=100 Ohm経由。BT1 pin 1はGND。C8=100 nF、充電禁止（DR-058） |
| 7 | VREF+ | Power | `3V3` | 100 nF。VDDA >= 2 VのときVREF+は2 V～VDDAの範囲が要求されるため`3V3`直結で適合。VREFBUFは有効化しない |
| 8 | VDD/VDDA | Power | `3V3` | 本パッケージ唯一のVDD。VDDAは内部でVDDへ結線されるためVDDA専用decouplingは不要。100 nF + bulk |
| 9 | VSS/VSSA | Power | `GND` | 本パッケージ唯一のVSS |
| 10 | PF0-OSC_IN | HSE bypass | `CLK_24M` | U14 pin 1 OUTをR8=33 Ohm経由で入力。TCXO/comparator/PLLの正常clock源 |
| 11 | PF1-OSC_OUT | GPIO | `NC_PF1` | HSE bypass時は未使用、回路図上NC |
| 12 | PF2-NRST | NRST | `NRST` | reset button/SWD。R9 10 kOhm pull-up、C16 100 nF |
| 13 | PC0 | GPIO | `NC_PC0` | 未使用、回路図上NC |
| 14 | PC1 | GPIO | `NC_PC1` | 未使用、回路図上NC |
| 15 | PC2 | GPIO | `NC_PC2` | 未使用、回路図上NC |
| 16 | PC3 | GPIO | `NC_PC3` | 未使用、回路図上NC |
| 17 | PA0 | USART4_TX (AF4) | `VLP_TX_MCU` | TXINV有効、U7D -> J4 pin 3 |
| 18 | PA1 | GPIO | `NC_PA1` | 未使用、回路図上NC。状態はJetson `GET_STATUS`とstatus LEDで通知する |
| 19 | PA2 | USART2_TX (AF1) | `JETSON_TX_MCU` | U7B -> J3 pin 3 |
| 20 | PA3 | USART2_RX (AF1) | `JETSON_RX_MCU` | U4C出力、RXINV有効 |
| 21 | PA4 | USART6_TX (AF3) | `IMU_TX_MCU` | U8D -> J6 pin 3。Spresense IMU向け。**`TT` = 3.6 V耐圧のみ** |
| 22 | PA5 | TIM2_CH1_ETR (AF2) | `GNSS_PPS_MON` | U4A出力、falling-edge capture。**`TT` = 3.6 V耐圧のみ** |
| 23 | PA6 | GPIO | `TP_FW_TRACE` | **TP9へ接続する唯一の汎用firmware trace出力。SWOではない。通常firmwareではanalog/no-pull、debug時だけGPIO出力** |
| 24 | PA7 | GPIO | `STAT_LED_N` | status LED |
| 25 | PC4 | GPIO | `NC_PC4` | 未使用、回路図上NC。VBAT monitorを採用する場合の候補（OI-005） |
| 26 | PC5 | TIM2_CH2 (AF2) | `PPS_GENERATED` | **常時使用するMCU hardware timer PPS。32-bit TIM2で生成** |
| 27 | PB0 | USART5_TX (AF8) | `MID360_TX_MCU` | U8B -> J5 pin 3 |
| 28 | PB1 | GPIO | `PPS_OE_N` | U7/U8/U12のPPS channel共通enable、100 kOhm pull-up |
| 29 | PB2 | GPIO | `IMU_TX_OE_N` | Spresense IMU TX buffer enable、100 kOhm pull-up |
| 30 | PB10 | GPIO | `NC_PB10` | 未使用、回路図上NC。TIM2_CH3は解放 |
| 31 | PB11 | USART3_RX (AF4) | `GNSS_NMEA_RX_MCU` | U4B出力、RXINV有効 |
| 32 | PB12 | GPIO | `JETSON_TX_OE_N` | Jetson TX buffer enable、100 kOhm pull-up |
| 33 | PB13 | GPIO | `VLP_TX_OE_N` | VLP TX buffer enable、100 kOhm pull-up |
| 34 | PB14 | GPIO | `MID360_TX_OE_N` | Mid-360 TX buffer enable、100 kOhm pull-up |
| 35 | PB15 | GPIO | `NC_PB15` | 未使用、回路図上NC。条件付きreset pull-down対象のため安全制御には使用しない |
| 36 | PA8 | GPIO | `NC_PA8` | 未使用、回路図上NC。条件付きreset pull-down対象のため安全制御には使用しない |
| 37 | PA9 | USART1_TX (AF1) | `AUX1_TX_MCU` | U12B -> J7 pin 3 |
| 38 | PC6 | LPUART2_TX (AF3) | `AUX2_TX_MCU` | U12D -> J8 pin 3 |
| 39 | PC7 | LPUART2_RX (AF3) | `AUX2_RX_MCU` | U4E出力、RXINV有効 |
| 40 | PD8 | GPIO | `NC_PD8` | 未使用、回路図上NC。**電源へ接続しない** |
| 41 | PD9 | GPIO | `NC_PD9` | 未使用、回路図上NC。**電源へ接続しない（旧版はVDDIO2と誤記）** |
| 42 | PA10 | USART1_RX (AF1) | `AUX1_RX_MCU` | U4D出力、RXINV有効 |
| 43 | PA11 | USB_DM | `USB_DN` | U11 MCU側 |
| 44 | PA12 | USB_DP | `USB_DP` | U11 MCU側 |
| 45 | PA13 | SWDIO | `SWDIO` | SWD pad TP1 |
| 46 | PA14-BOOT0 | SWCLK/BOOT0 | `SWCLK_BOOT0` | SWD pad TP2/BOOT control |
| 47 | PA15 | GPIO | `NC_PA15` | 未使用、回路図上NC。専用DFU buttonには使用しない |
| 48 | PC8 | GPIO | `NC_PC8` | 未使用、回路図上NC |
| 49 | PC9 | GPIO | `NC_PC9` | 未使用、回路図上NC |
| 50 | PD0 | GPIO | `NC_PD0` | 未使用、回路図上NC。条件付きreset pull-down対象 |
| 51 | PD1 | GPIO | `NC_PD1` | 未使用、回路図上NC |
| 52 | PD2 | GPIO | `NC_PD2` | 未使用、回路図上NC。条件付きreset pull-down対象 |
| 53 | PD3 | GPIO | `NC_PD3` | 未使用、回路図上NC |
| 54 | PD4 | GPIO | `NC_PD4` | 未使用、回路図上NC |
| 55 | PD5 | GPIO | `NC_PD5` | 未使用、回路図上NC |
| 56 | PD6 | GPIO | `NC_PD6` | 未使用、回路図上NC |
| 57 | PB3 | GPIO | `NC_PB3` | 未使用、回路図上NC。生成源はTP6、各出力はコネクタpin 2で実測する |
| 58 | PB4 | GPIO | `NC_PB4` | 未使用、回路図上NC。GNSS有効性はJetson `GET_STATUS`で通知する |
| 59 | PB5 | GPIO | `NC_PB5` | 未使用、回路図上NC |
| 60 | PB6 | GPIO | `NC_PB6` | 未使用、回路図上NC |
| 61 | PB7 | GPIO | `NC_PB7` | 未使用、回路図上NC |
| 62 | PB8 | GPIO | `AUX1_TX_OE_N` | 予備UART 1 TX buffer enable、100 kOhm pull-up |
| 63 | PB9 | GPIO | `AUX2_TX_OE_N` | 予備UART 2 TX buffer enable、100 kOhm pull-up |
| 64 | PC10 | GPIO | `NC_PC10` | 未使用、回路図上NC |

pin数の検算: I/O 60本（PA0～PA15、PB0～PB15、PC0～PC15、PD0～PD6、PD8、PD9、PF0～PF2）+ 電源4本 = 64。ST CubeMX pin databaseの`IONb=60`と一致する。

`VDD`と`VREF+`は3.3 V系、`VBAT`はCR2032由来の`VBAT_RTC`へ接続し、各電源pin直近へ100 nFを置く。

PA9/PA11とPA10/PA12のremapについて、ST CubeMX pin databaseの記述は次のとおりである。**default状態を使用し、remapは有効化しない。**

| Position | default | remap variant |
|---:|---|---|
| 37 | `PA9` | `UCPD1_DBCC1`（PINREMAP時） |
| 42 | `PA10` | `UCPD1_DBCC2`（PINREMAP_10_12時） |
| 43 | `PA11 [PA9]` | `PA9 [PA11]`（PINREMAP時） |
| 44 | `PA12 [PA10]` | `PA10 [PA12]`（PINREMAP_10_12時） |

本パッケージはPA9（pin 37）とPA11（pin 43）、PA10（pin 42）とPA12（pin 44）を別pinとして持つため、`AUX1_TX_MCU`（USART1_TX / PA9）と`USB_DN`（PA11）、`AUX1_RX_MCU`（USART1_RX / PA10）と`USB_DP`（PA12）は競合しない。remapを有効化するとpin 37/42がUCPD用になるため、SYSCFGのremap bitはreset値のままにする（DS13560 Table 12 note 5）。

### 耐圧とdomainの注意

- **PA4とPA5は`TT`（3.6 V tolerant）であり、他の使用pinの`FT`（5 V tolerant）とは異なる。** PA5はU4A（3.3 V）出力駆動、PA4は出力専用のため現構成は適合するが、**この2 pinへ5 V信号を接続してはならない。** VLP-32C系（High上限5.0 V）をMCUへ直結する変更を行う場合は`FT` pinを選ぶ。
- **PC13～PC15の制約（DS13560 Table 12 note 1/2、ES0548 §2.2.6）:** RTC power switch経由のdomainである。PC13のsignal transitionはworkaroundなしでLSEを乱し得るため、PC14/PC15はLSE専用、PC13は未使用とし、firmwareはTAMP/RTC_OUTをPC13へ割り付けない。PC13配線もLSE loopへ近づけない。

### VDDIO2 domainのI/O

DS13560 Table 11の`_s`は「I/O, supplied from VDDIO2 only」を意味する。本パッケージにVDDIO2 pinはなく内部でVDDへ結線されるが、`PWR_CR2`の`PVM_VDDIO2[2:0]`はreset値000で「Monitoring disabled; IOs in isolation mode」である。**firmware初期化で`PVM_VDDIO2 = 110`（Monitoring bypassed; IOs enabled）を設定する。**

本設計でVDDIO2 domainに属するnetは次のとおりである。

| Net | Pin | I/O structure |
|---|---|---|
| `AUX1_TX_MCU` / `AUX1_RX_MCU` | PA9 / PA10 | `FT_s` / `FT_fds` |
| `USB_DN` / `USB_DP` | PA11 / PA12 | `FT_fus` |
| `SWDIO` / `SWCLK_BOOT0` | PA13 / PA14 | `FT_es` / `FT_s` |
| `NC_PA15` | PA15 | `FT_s` |
| `VLP_TX_OE_N` / `MID360_TX_OE_N` | PB13 / PB14 | `FT_fs` |
| `AUX2_TX_MCU` / `AUX2_RX_MCU` | PC6 / PC7 | `FT_s` |
| `NC_PD0`～`NC_PD3` | PD0～PD3 | `FT_cs` / `FT_ds` |

- **powered時刻機能の中核はVDD domainである。** `CLK_24M`（PF0）、`PPS_GENERATED`（PC5）、`GNSS_PPS_MON`（PA5）、Jetson UART（PA2/PA3）、VLP/Mid/Spresense TX（PA0/PB0/PA4）、`PPS_OE_N`（PB1）はいずれも`_s`ではない。LSE/内蔵RTC/VBATはbackup domainで暦を保持する。
- `VLP_TX_OE_N`/`MID360_TX_OE_N`が万一isolationされても、外付け100 kOhm pull-upがbufferをHigh-Zへ保つため安全側に失敗する。
- **診断:** 「Jetson UART・PPS・RTCは動作するが、USBが列挙されず、J7/J8が無反応で、VLPとMid-360のNMEAだけ出ない」場合は`PVM_VDDIO2`を最初に確認する。

### EasyEDA入力時の必須確認

初回試作では、発注版の回路図netlistで下の4点を含む全pinを確認済みである。次版で部品を置き直すときも同じ確認を行う。

EasyEDA/LCSCが提供するMCU symbolを配置した直後に、**symbol上のpin番号と本表を1本ずつ突き合わせる。** 旧版の表はpin 1～32および40～41が実物と不一致だったため（DR-012）、表を信用してsymbol確認を省略してはならない。特に次の4点を確認する。

1. pin 8がVDD、pin 9がVSSであること。pin 12がPF2-NRSTであること。
2. pin 40/41がPD8/PD9であり、電源netへ接続されていないこと。
3. pin 3がPC13（`NC_PC13`）、pin 4/5がPC14/PC15（LSE）、pin 10がPF0（`CLK_24M`）、pin 26がPC5（`PPS_GENERATED`）であること。
4. `VDDIO2`という名前のpinが存在しないこと。

## MCU clock構成

| 項目 | 構成 | 備考 |
|---|---|---|
| SYSCLK / timer clock源 | 24 MHz TCXO + comparator + HSE bypass + PLL、48 MHz | PLLM=2、PLLN=16、PLLR=4。PF0入力はduty 45～55 %、PF1 NC。Voltage Range 1、Flash 2 wait state |
| timer clockの周波数基準 | **YXC OW7EL89CENUYO3YLC-24M / C22434890、温度安定度±1.5 ppm** | clipped sineをU14 LMV7219で3.3 V CMOS化し、R8経由でPF0へ入力。C48677994/C51822852/C51966238は採用解除 |
| UTCの絶対基準 | GNSS PPS + 検証済みNMEA | GNSS有効中はDPLLで位相・周波数を規律する |
| USB clock | PLLQ=48 MHz | PLLM=2、PLLN=16、PLLQ=4。HSI48/CRSを使用しない。0～40 ℃で列挙を確認する |
| UART baud生成 | TCXO/PLL由来 | 温度安定度±1.5 ppm級。追加BRR補正は不要 |
| calendar / power-off保持 | STM32内蔵RTC + X1 LSE + CR2032 | LSEは±20 ppm級。powered holdoverのPPS基準には使わない |

## PPS/holdoverのtimer構成

生成PPSと入力captureは**すべて32-bit TIM2へ集約する。** `stm32g0b1xx.h`の`IS_TIM_32B_COUNTER_INSTANCE(INSTANCE) ((INSTANCE) == TIM2)`により、32-bit counterを持つtimerはTIM2だけである。16-bitのTIM3ではARR上限65535のためtick 15.26 us以上となり、PPS位相1 us目標と周波数分解能3.33 ppmを満たせない。

| TIM2 channel | Pin | 用途 |
|---|---|---|
| CH1 (AF2) | PA5 / pin 22 | GNSS PPS input capture（U4で反転するためfalling edge） |
| CH2 (AF2) | PC5 / pin 26 | 生成PPS output compare / PWM |
| CH3 | 使用しない | PB10は未使用GPIO |
| CH4 | 使用しない | PA3/PB11はUSART2_RX/USART3_RXが使用する |

- `ARR = 47999999`（ARPE有効）、`CCR2 = 4800000`で周期1秒・High幅100 msとなる。tickは約20.833 ns、周期補正1 LSBは約0.0208 ppmである。
- ARRを1秒に設定するとcounterが「秒内位相」そのものになり、CH1のcapture値がそのまま位相誤差になる。
- **PWM mode 1・上カウント・active highでは、出力は`CNT < CCR2`の間Highとなる。したがってPPSの立上りedgeはcounter reset（update event）で決まり、`CCR2`が動かすのは立下りedge＝High幅だけである。**
  - 周波数補正も位相補正も**ARR**で行う。位相はQ-017の±100 us/s以内でARRを増減し、秒境界を歩かせて戻す。
  - `CCR2 = 4800000`はHigh幅100 ms（Q-011）を決める固定値であり、ARRを変えても更新しない。
  - `CCR2`を位相補正に使わない。使ってもPPSの基準edgeは動かない。
- TIM2は他用途へ割り当てない。PA6/TIM3_CH1はPPS生成には使用せず、GPIO `TP_FW_TRACE`としてTP9へ接続する。生成PPSはPC5に接続したTP6で直接測定する。
- `PPS_GENERATED`をPC5へ移したことによるreset時の懸念はない。reset中の出力状態は`PPS_OE_N`（PB1、100 kOhm pull-up）が74LVC125AをHigh-Zに保つことで決まり、PC5のreset時状態には依存しない。

## テストパッド割当

初回試作のテストパッドは次の9点だけとする。TP9だけを汎用firmware trace用として残し、その他のstatus/spare/debug GPIO用パッドと、コネクタから測定できる通常PPS出力の重複パッドは設けない。

| TP | Net | 用途・配置 |
|---|---|---|
| TP1 | `SWDIO` | SWD復旧 |
| TP2 | `SWCLK_BOOT0` | SWD復旧 |
| TP3 | `NRST` | SWD復旧 |
| TP4 | `3V3` | SWD reference/給電確認 |
| TP5 | `GND` | SWD GND。TP6のprobe GNDとしても使える位置へ配置 |
| TP6 | `PPS_GENERATED` | MCU生成源の測定。TP5近傍に配置 |
| TP7 | `VLP_PPS_OUT` | J4 pin 1 GND近傍、出力測定と1.5 kOhm負荷接続を兼用 |
| TP8 | `VLP_TX_OUT` | J4 pin 1 GND近傍、1.5 kOhm負荷接続と波形測定 |
| TP9 | `TP_FW_TRACE` | PA6の汎用firmware event trace。probe GNDを短く取れるGND近傍へ配置。SWOではない |

J3/J5/J6/J7/J8のPPSは各コネクタpin 2から、pin 1をGNDとして測定する。信号測定用の恒久パッドは、buffer前の生成源TP6、1.5 kOhm負荷を仮付けするVLP用TP7/TP8、唯一の汎用firmware trace用TP9だけとする。PPS間チャネルスキュー試験には測定用ハーネスを使用する。

## コネクタ割当

| Ref | Part | Pin 1 | Pin 2 | Pin 3 | Pin 4 |
|---|---|---|---|---|---|
| J2 | GH 3 pin / UM982 | GND | `J2_PPS` | `J2_NMEA` | - |
| J3 | GH 4 pin / Jetson | GND | `JETSON_PPS_OUT` | `JETSON_TX_OUT` | `J3_RX` |
| J4 | GH 3 pin / VLP-32C | GND | `VLP_PPS_OUT` | `VLP_TX_OUT` | - |
| J5 | GH 3 pin / Mid-360 | GND | `MID360_PPS_OUT` | `MID360_TX_OUT` | - |
| J6 | GH 3 pin / Spresense IMU level board | GND | `IMU_PPS_OUT` | `IMU_TX_OUT` | - |
| J7 | GH 4 pin / AUX UART 1 | GND | `AUX1_PPS_OUT` | `AUX1_TX_OUT` | `J7_RX` |
| J8 | GH 4 pin / AUX UART 2 | GND | `AUX2_PPS_OUT` | `AUX2_TX_OUT` | `J8_RX` |

J2/J3/J7/J8の外部入力ラベルは直列抵抗よりU4側に置く。コネクタpinから直列抵抗までの短い区間はEasyEDA実回路図では無名netであり、上表の`J2_PPS`/`J2_NMEA`/`J3_RX`/`J7_RX`/`J8_RX`は参照生成用の論理名であってEasyEDAラベルではない。直列抵抗後の実ラベルは順に`GNSS_PPS_IN`、`GNSS_NMEA_RX_IN`、`JETSON_RX_IN`、`AUX1_RX_IN`、`AUX2_RX_IN`とする。

この表は基板側J2～J8の割当である。相手機器側connector、pin番号、線色は試作ハーネス製作前のTBDとし、[`harness_pinout.md`](./harness_pinout.md)で管理する。基板側割当を変更する場合は本表、BOM、ハーネス表を同時に更新する。

## 出力buffer channel割当

3.3 V出力はU7/U8/U12 `74LVC125A`を使用する。U9/U13は使用しない。旧VLP用途のU5/U6は欠番のままとする。U14はclock comparator専用、U15は配置しない。

| IC channel | Input | Output | `/OE` net | Connector |
|---|---|---|---|---|
| U7A | `PPS_GENERATED` | `JETSON_PPS_OUT` | `PPS_OE_N` | J3 pin 2 |
| U7B | `JETSON_TX_MCU` | `JETSON_TX_OUT` | `JETSON_TX_OE_N` | J3 pin 3 |
| U7C | `PPS_GENERATED` | `VLP_PPS_OUT` | `PPS_OE_N` | J4 pin 2、3.3 V試作出力 |
| U7D | `VLP_TX_MCU` (`TXINV=1`) | `VLP_TX_OUT` | `VLP_TX_OE_N` | J4 pin 3、3.3 V試作出力 |
| U8A | `PPS_GENERATED` | `MID360_PPS_OUT` | `PPS_OE_N` | J5 pin 2 |
| U8B | `MID360_TX_MCU` | `MID360_TX_OUT` | `MID360_TX_OE_N` | J5 pin 3 |
| U8C | `PPS_GENERATED` | `IMU_PPS_OUT` | `PPS_OE_N` | J6 pin 2 |
| U8D | `IMU_TX_MCU` | `IMU_TX_OUT` | `IMU_TX_OE_N` | J6 pin 3 |
| U12A | `PPS_GENERATED` | `AUX1_PPS_OUT` | `PPS_OE_N` | J7 pin 2 |
| U12B | `AUX1_TX_MCU` | `AUX1_TX_OUT` | `AUX1_TX_OE_N` | J7 pin 3 |
| U12C | `PPS_GENERATED` | `AUX2_PPS_OUT` | `PPS_OE_N` | J8 pin 2 |
| U12D | `AUX2_TX_MCU` | `AUX2_TX_OUT` | `AUX2_TX_OE_N` | J8 pin 3 |
- PPS 6 channelは入力だけを`PPS_GENERATED`へ共通接続し、出力は相互接続しない。
- 各ICのVCC-GND間へ100 nF decouplingを1個ずつ配置する。
- すべての`/OE`はactive-low。reset中はpull-upでHigh-Zとする。

### VLP 3.3 V試作出力

- VLP-32C公式条件はPPS/NMEAともHigh >3.0 Vかつ<5.0 V、Low <1.2 V、High時2 mA供給である。
- U7C/U7Dは`3V3`駆動のためHigh上限5.0 V未満とLow条件は満たす。Nexperia 74LVC125AはVCC=3.0 V、IOH=-18 mAでVOH min 2.4 Vを規定するが、3.3 V・2 mAに対するVOH minは表で直接規定していない。このためHigh >3.0 V @ 2 mAは文書上のworst-case保証ではなく試作実測項目とする。
- J4 pin 2/3を各1.5 kOhmでGNDへ負荷し、R21/R23=10 Ohm後のHighが3.0 Vを超え、Lowが1.2 V未満であることを全試作基板で確認する。規定されていない動作点の補間値は保証根拠に使わず、VLP実機でもPPS/NMEA lockを確認する。
- 不合格の場合は3.3 V出力を無理に使用せず、次版で専用level driverを再設計する。

## PPSロジック接続

```text
J2 -> R13 -> GNSS_PPS_IN -> U4A SN74LV14A -> GNSS_PPS_MON -> MCU PA5 TIM2_CH1 falling-edge capture
MCU PC5 TIM2_CH2 PPS_GENERATED -> U7A/U7C/U8A/U8C/U12A/U12C -> J3/J4/J5/J6/J7/J8 PPS
MCU PB1 PPS_OE_N -> all six PPS channels /OE, 100 kOhm pull-up
```

GNSS正常時もPPSを直接pass-throughせず、PC5のTIM2出力比較をGNSS PPSへ規律する。GNSS復帰時は周期を1秒当たり最大±100 usだけ変化させて位相を連続的に戻す。

GNSS PPS経路の固定遅延は、R13（4.7 kOhm）とU4A入力容量2.3 pFおよび配線/source容量によるRC、U4Aの伝搬遅延、capture同期遅延の和である。旧74HC14を前提にした55～82 ns/27 ns差の概算は使用せず、基板ごとの固定offsetとして実測・校正し、DPLLの位相補正値へ含める。

### U4外部入力bias

R13/R16～R19の4.7 kOhm直列抵抗よりU4側に、次の100 kOhm biasを配置する。これによりJ2/J3/J7/J8未接続時もSchmitt入力が浮かない。

| Reference | U4 channel / signal | Bias | Default状態 |
|---|---|---|---|
| R14 | U4A / `GNSS_PPS_IN` | 100 kOhm to GND | PPS inactive Low |
| R15 | U4B / `GNSS_NMEA_RX_IN` | 100 kOhm to `3V3` | UART idle High |
| R39 | U4C / `JETSON_RX_IN` | 100 kOhm to `3V3` | UART idle High |
| R40 | U4D / `AUX1_RX_IN` | 100 kOhm to `3V3` | UART idle High |
| R41 | U4E / `AUX2_RX_IN` | 100 kOhm to `3V3` | UART idle High |

U4F inputは従来どおりGNDへ固定し、outputはNCとする。

## NMEAロジック接続

```text
J2 -> R16 -> GNSS_NMEA_RX_IN -> U4B SN74LV14A -> GNSS_NMEA_RX_MCU -> MCU USART3_RX (RXINV=1)
MCU PA2 USART2_TX / JETSON_TX_MCU -> U7B -> J3 JETSON_TX_OUT
J3 -> R17 -> JETSON_RX_IN -> U4C SN74LV14A -> JETSON_RX_MCU -> MCU USART2_RX (RXINV=1)
MCU USART4_TX (TXINV=1) / VLP_TX_MCU -> U7D 74LVC125A -> J4 VLP_TX_OUT
MCU PB13 VLP_TX_OE_N -> U7D /OE, 100 kOhm pull-up
MCU PB0 USART5_TX / MID360_TX_MCU -> U8B -> J5 MID360_TX_OUT
MCU PA4 USART6_TX / IMU_TX_MCU -> U8D -> J6 IMU_TX_OUT
MCU PB2 IMU_TX_OE_N -> U8D /OE, 100 kOhm pull-up
MCU PA9 USART1_TX / AUX1_TX_MCU -> U12B -> J7 AUX1_TX_OUT
J7 -> R18 -> AUX1_RX_IN -> U4D SN74LV14A -> AUX1_RX_MCU -> MCU USART1_RX (RXINV=1)
MCU PC6 LPUART2_TX / AUX2_TX_MCU -> U12D -> J8 AUX2_TX_OUT
J8 -> R19 -> AUX2_RX_IN -> U4E SN74LV14A -> AUX2_RX_MCU -> MCU LPUART2_RX (RXINV=1)
U4F SN74LV14A input -> GND; output -> NC
```

6系統のTXはすべて別のUART/LPUART peripheralと別のbuffer channelを使う。各bufferの`OE_N`も個別GPIOで制御し、R32～R38の100 kOhm pull-upでreset中High-Zとする。外部出力の直列抵抗は通常33 Ohm、VLP PPS/NMEAのR21/R23だけ10 Ohmとする。U4外部入力は4.7 kOhm直列抵抗を経由させる。VLPのUSART TX pinはreset中の外部buffer出力がHigh-Zになるよう`OE_N`で制御する。

## 試作機の電源順序制約

U4 `SN74LV14ADR`は`Ioff`に対応し、VCC=0 V時の入力部分給電防止を規定している。ただしコネクタ側機器、出力buffer、MCUを含むシステム全体のhot-plug耐性は未保証であるため、初回試作では次を運用条件とする。

1. J2～J8は全機器の電源OFF中に接続・切断し、hot-plugしない。
2. 入力を駆動するUM982、Jetson、AUXより先、または同時に本基板へ給電する。本基板だけを先にOFFしない。
3. 接続先をOFFする前に`PPS_OE_N`と各`*_TX_OE_N`をHighへして全出力をHigh-Zにする。
4. firmware初期化完了までは全`OE_N`をHighに保ち、接続先の電源ON確認後に必要channelだけenableする。

この条件を守れない用途、hot-plug、量産版では、接続先power sense/isolationと出力側の部分給電経路を再検討する。

## TCXO、HSE bypass、LSE接続

```text
3V3 -> U2 YXC OW7EL89CENUYO3YLC-24M pin 4 VCC
U2 pin 1 NC（未接続）; U2 pin 2 -> GND
U2 pin 3 clipped-sine OUT -> C11 1 nF -> U14 pin 3 +IN
3V3 -> R5 33 kOhm -> VREF_CLK -> R6 15 kOhm -> GND
VREF_CLK -> C12 100 nF -> GND
VREF_CLK -> U14 pin 4 -IN
VREF_CLK -> R7 10 kOhm -> U14 pin 3 +IN
3V3 -> U14 pin 5 VCC; U14 pin 2 -> GND; C13 100 nFをpin 5/2直近
U14 pin 1 push-pull OUT -> R8 33 Ohm -> CLK_24M -> MCU PF0/OSC_IN
MCU PF1/OSC_OUT -> NC

MCU PC14/OSC32_IN -- X1 SC-32S 32.768 kHz -- MCU PC15/OSC32_OUT
PC14 -- C14 10 pF C0G ±5% -- GND
PC15 -- C15 10 pF C0G ±5% -- GND
BT1 pin 2 / CR2032+ -> R4 100 Ohm -> VBAT_RTC -> MCU VBAT
BT1 pin 1 / CR2032- -> GND
```

- U2 pin 4/2直近へC10=100 nFを置く。U14/C11/C12/C13/R5-R8を実装し、U15および`+2V8_CLK`は作成しない。電源投入後5 ms以上待ってHSE bypass/PLLへ切り替える。
- X1のCL=7 pFに対し基板寄生を約2 pFと仮定し、C14/C15は10 pFを初期値とする。SC-32SのESR最大70 kOhm、C0 typ 1 pF、CL 7 pFから`gmcrit`は概算0.76 uA/Vとなるため、STM32は`LSEDRV=10`（medium-high、`Gmcritmax` 1.7 uA/V）で使用する。low/medium-lowは不適合、highは過励振を悪化させるため使用しない。
- 試作では8.2～12 pFを調整するとともに、発振loopへ直列抵抗`RADD`を挿入して`Sf = (RADD + ESR) / ESR >= 3`を0 ℃、40 ℃、CR2032単独給電で確認する。1 pF以下のprobeでOSC_IN側`Vpp`を測定し、`DL = ESR x (pi F Ctot)^2 x Vpp^2 / 2 < 0.5 uW`を確認する。過励振時はdriveを下げられないため水晶を変更する。
- U2 pin 3→C11→U14 pin 3、およびU14 pin 1→R8→PF0はGND plane上を短く配線する。R8はPF0直近、R5-R7/C11-C13はU14直近へ置く。clock配線のtest padは小型・stub最小とする。
- X1とC14/C15はPC14/PC15直近へ配置し、X1直下および発振loop内に信号配線を通さない。裏面には他のGND planeからギャップで区別したローカルGND planeを置き、最寄りのMCU GNDへ一点接続する。X1/C14/C15の周囲にはGND guard ringを設ける。PC13はNCとし、その配線も近づけない。**初回試作ではローカルGND planeとguard ringを作っていない**（4層のInner1のGND全面の上にある）。発振loop内に他のnetの配線やviaがない点は満たしている。
- U2は24 MHz、clipped sine 0.8 Vp-p min、10 kOhm // 10 pF、-30～85 ℃で±1.5 ppm、2.0 mA maxである。U14は2.7～5 V、push-pull出力、7 mV hysteresis、20 ns max propagation delay品である。両部品のsymbol/padを回路図・PCB・現物で照合し、C22434890/C544337以外へ無断代替しない。C48677994/C51822852/C51966238は使用しない。
- HSE Clock Security Systemを有効化する。HSE/PLL faultでHSIへ切り替わった場合、時刻出力は継続せず全`OE_N`をHighにして`FAULT_CLOCK`へ遷移する。

## RESET / BOOT / DFU

- SW1 `RESET`は`NRST`（pin 12）とGND間。R9 10 kOhmで`NRST`を`3V3`へpull-upし、C16 100 nFを`NRST`-GND間へ配置する。
- SW2 `BOOT`は`3V3`からR10 1 kOhmを介してPA14-BOOT0へ接続する。R11 100 kOhmでPA14-BOOT0をGNDへpull-downする。
- SW1/SW2は小型Basic `TS-1088-AR02016` / C720477、SMD 4 x 3 mmを使用する。
- PA14はSWCLK兼用である。STM32G0B1 errata ES0548 §2.2.8により、debug接続後はprobeを外しただけではBOOT0 sampling状態が戻らない。SWD probeを外し、USBを含む全主電源を切って完全power cycleした後にSW2 + SW1のBOOT操作を行う。
- option byteを`nBOOT_SEL=0`、`nBOOT1=1`として外部BOOT0とsystem-memory bootを有効化する（AN2606の一般表では`nBOOT_SEL`を`nBOOT0_SEL`と表記）。通常起動はBOOT Low、system-memory USB DFUはSW2を押したままSW1を押して離し、その後SW2を離す。
- **試験中の2枚はoption byteを変更していない（出荷時の`nBOOT_SEL=1`のまま）。** このためSW2+SW1ではDFUに入れず、DFUへはconsoleの`dfu` commandで移る。Rev Aの基板でoption byteを変更するかは判断待ちである（[`../../firmware/test_plan.md`](../../firmware/test_plan.md) P-22）。
- PA15の専用`DFU_REQ_N` buttonは設けない。正常firmwareからはUSB CDC commandによるsystem bootloader移行を実装し、firmware異常時はSW1/SW2を使用する。
- SWD recovery用TP1～TP5（SWDIO、SWCLK、NRST、3V3、GND）は維持する。

### 初回bring-up手順（DR-021）

**JLCPCBのPCBAはfirmware書込みもoption byte設定も行わない。** 上記のoption byte設定は基板受領後にユーザーが実施する工程である。レジスタの所在も区別する。

- `nBOOT_SEL`（bit 24）、`nBOOT1`（bit 25）、`nBOOT0`（bit 26）は`FLASH_OPTR`のoption byteである。
- `BOOT_LOCK`はoption byteではなく`FLASH_SECR`のbit 16である。**初回試作では変更せず既定値のままとする。**

未書込みの新品基板は空flash判定（RM0444 §2.5.4、`FLASH_ACR`の`EMPTY` bit）でsystem bootloaderへ入るため、SWD probeなしでもUSB DFUで認識できる。判定はmainフラッシュがboot対象かつ`BOOT_LOCK`未セットのときに行われる。次の順序で立ち上げる。

1. 新品基板をUSBへ接続し、空flash判定によりsystem bootloaderが起動してDFU deviceとして見えることを確認する。DFUで初回firmwareを書き込む。
2. **書込み後はUSBを抜き差しして電源を入れ直す。** `EMPTY`フラグのクリアにはpower on resetまたは`OBL_LAUNCH`が必要で、**system reset（SW1）では clear されない。** SW1だけを押しても新firmwareは起動せず再びbootloaderへ入る。ただし現在のfirmwareは起動時に自分で`EMPTY`を0にしてresetし直すので、電源の入れ直しは要らない（[`../../firmware/README.md`](../../firmware/README.md)）。
3. option byteを`nBOOT_SEL=0`、`nBOOT1=1`へ設定し、SW2 + SW1によるDFU移行を有効にする。BOOT0はNRSTの立上りedgeでサンプリングされるため、SW2を押したままSW1を押して離す手順が正しい。（試験中の2枚では未実施。上記のP-22を参照）
4. 上記が失敗した場合はTP1～TP5経由のSWDで書き込む。SWD使用後にBOOT+RESETを再試行するときは、probeを外して全主電源を完全power cycleしてから行う。

option byte変更前にTP1～TP5の導通を確認し、`DBGMCU_IDCODE.REV_ID`を記録する。Rev A（`REV_ID=0x1000`）はES0548 §2.2.9の対象で、option byte不整合により`BOOT_LOCK`とRDPが自動設定されると復旧不能になり得る。安定したUSB給電で書込み、option byte reloadとsystem resetが完了するまでUSBを抜かない。

## firmware初期化の必須項目

回路ではなくfirmwareでしか担保できない条件を、bring-up前の確認項目として記録する。

| 項目 | 内容 |
|---|---|
| `OE_N`初期値 | 全`OE_N` GPIOは出力値をHighへ設定した後にoutput modeへ切り替える。Low glitchを出さない |
| `TP_FW_TRACE`初期値 | PA6は通常firmwareでanalog/no-pullのまま維持する。明示的なdebug buildまたは設定時だけ出力dataをLowにしてからGPIO outputへ切り替える。製品機能をTP9の状態へ依存させない |
| VREFBUF | VREF+を外部から3.3 Vで駆動するため有効化しない |
| `PWR_CR2`の`PVM_VDDIO2[2:0]` | **`110`（Monitoring bypassed; IOs enabled）を設定する。** reset値000は「IOs in isolation mode」であり、USB・SWD・AUX1/AUX2 UART・VLP/Mid TXのOE_NがVDDIO2 domainに属する。上記「VDDIO2 domainのI/O」参照 |
| `SYSCFG_CFGR1`の`UCPD1_STROBE` / `UCPD2_STROBE` | **起動時にstrobeしてdead-battery pull-downを無効化する。** DS13560 Table 12 note 4により、reset時PA8/PB15/PD0/PD2にpull-downが present し得る（PA9/PA10/PD1/PD3の電圧に依存）。これらはすべて回路図上NCだが、将来のpin再利用に備えて初期化を維持する |
| clock tree | 電源投入後5 ms以上待ち、HSE bypass、HSE=24 MHz、PLLM=2、PLLN=16、PLLR=4、SYSCLK/TIM2=48 MHzを設定。Voltage Range 1の`VOSF=0`確認後、Flashを2 wait stateへ設定してからSYSCLKを切り替える。PF0 duty 45～55 %を前提とし、HSE CSSを有効化する |
| USB clock | PLLQ=4で48 MHzを生成する。HSI48/CRSは使用しない |
| 内蔵RTC | LSEをclock源とし、`LSEDRV=10`、`LSECSSON=0`とする。backup registerにsignature/version、TCXO補正値、同期時刻、application payload CRC、RTC-domain configuration CRCを保存する。PC13へTAMP/RTC_OUTを割り付けない。RTC INITを抜けた後に再度INITへ入る場合は、`BYPSHAD`をclearして`RSF`の立上りを待ち、calendar全registerを1回のINIT sessionで書く（ES0548 §2.9.1） |
| timer edge極性 | GNSS PPSはU4Aで反転するためTIM2_CH1 falling-edge capture |
| clock規律 | GNSS有効中はCH1 PPSからTCXO実偏差と位相を推定する。holdoverでは最後に検証済みのARR補正値を保持する |
| UART baud | TCXO/PLL由来。通常はBRRの動的補正不要 |
| TIM2構成 | `ARR = 47999999`、ARPE有効、`CCR2 = 4800000`（High幅100 ms固定）。**周波数補正と位相補正はいずれもARRで行う。** |
| RTC有効性 | 起動処理の最初かつreset flag clear前に`BORRSTF`を保存し、signature/version、両CRC、`INITS`、RTCSEL/LSEON/LSERDY/RTCEN、calendar範囲、SSR単調性を確認する。CRC/設定異常ではBDRSTをset/read-back/clearし、外部へ時刻を出さない。正常確認後にreset flagをclearする。`RTC_VALID`は主電源断中のLSE連続動作や電池残量を保証しない |
| clock fault | HSE/PLL異常時はHSIへ診断退避し、全`OE_N`をHigh、`FAULT_CLOCK`へ遷移する |
