CoderDojoMusashikosugi/cub_2026_timing_sync_if_board/hardware/overall/bom_preliminary.csv

Category | References | Qty | Manufacturer Part Number | JLCPCB Part Number | Package | JLCPCB Library | Promotional / Preferred | Stock | Reservable | Checked at (JST) | Assembly | Decision / note | JLCPCB detail URL
MCU | U1 | 1 | STM32G0B1RCT6 | C3034735 | LQFP-64(10x10) | Extended | No | 173 | 104 | 2026-09-06 | PCBA | DR-060で旧STM32G0B1RBT6/C5143679(在庫0)から変更。pinout・EasyEDA package uuidとも同一でPCB変更不要。Flash 256 KB。N接尾辞品へ差し替え禁止 | https://jlcpcb.com/partdetail/STMicroelectronics-STM32G0B1RCT6/C3034735
24 MHz clipped-sine TCXO | U2 | 1 | OW7EL89CENUYO3YLC-24M | C22434890 | SMD2016-4P | Extended | No |  |  | 2026-08-15 | PCBA | 24 MHz / 3.3 V。pin 1=NC、2=GND、3=OUT、4=VCC。品番固有仕様書は発注前確認 | https://jlcpcb.com/partdetail/C22434890
3.3 V LDO | U3 | 1 | TPS70933DBVR | C89347 | SOT-23-5 | Extended | No |  |  | 2026-08-15 | PCBA | DR-059。pin 1=IN、2=GND、3=EN、4=NC（発注版の回路図ではGNDへ接続）、5=OUT。IN/EN=VBUS_PROTECTED、OUT=3V3。逆電流保護内蔵、150 mA連続/200 mA peak、2.7～30 V、3.3 V固定 | https://jlcpcb.com/partdetail/TexasInstruments-TPS70933DBVR/C89347
Hex inverting Schmitt buffer | U4 | 1 | SN74LV14ADR | C475503 | SOIC-14 | Extended | No |  |  | 2026-08-15 | PCBA | DR-057。74x14標準pinout。3.3 V規定とIoff対応。U4F inputはGND固定 | https://jlcpcb.com/partdetail/C475503
Quad output buffer | U7 U8 U12 | 3 | 74LVC125APW,118 | C6059 | TSSOP-14 | Extended | No |  |  | 2026-08-15 | PCBA | 全12出力を担当。U7=J3/J4、U8=J5/J6、U12=J7/J8 | https://jlcpcb.com/partdetail/Nexperia-74LVC125APW118/C6059
USB ESD | U11 | 1 | USBLC6-2SC6 | C7519 | SOT-23-6L | Extended | No |  |  | 2026-08-15 | PCBA | pin 1/6=I/O1、3/4=I/O2、2=GND、5=VBUS。ST datasheet照合済み | https://jlcpcb.com/partdetail/STMicroelectronics-USBLC62SC6/C7519
High-speed comparator | U14 | 1 | LMV7219M7X/NOPB | C544337 | SC-70-5 | Extended | No |  |  | 2026-08-15 | PCBA | U2 clipped sineを3.3 V CMOS化 | https://jlcpcb.com/partdetail/TexasInstruments-LMV7219M7XNOPB/C544337
32.768 kHz LSE crystal | X1 | 1 | SC-32S32.768kHz20PPM7pF | C97604 | SMD3215-2P | Extended | No |  |  | 2026-08-15 | PCBA | CL 7 pF / ±20 ppm。PC14/PC15へ接続 | https://jlcpcb.com/partdetail/C97604
USB Type-C | J1 | 1 | TYPE-C-31-M-12 | C165948 | SMD | Extended | No |  |  | 2026-08-15 | PCBA | USB 2.0 device/power用16 pin receptacle | https://jlcpcb.com/partdetail/Korean_HropartsElec-TYPE_C_31_M12/C165948
GH-compatible 3 pin | J2 J4 J5 J6 | 4 | A1257WR-S-3P | C225126 | SMD 1.25 mm right-angle | Extended | No |  |  | 2026-08-15 | PCBA | 相手側A1257H-3P・端子A1257-TP | https://jlcpcb.com/partdetail/225409-A1257WR_S3P/C225126
GH-compatible 4 pin | J3 J7 J8 | 3 | A1257WR-S-4P | C225127 | SMD 1.25 mm right-angle | Extended | No |  |  | 2026-08-15 | PCBA | 相手側A1257H-4P・端子A1257-TP | https://jlcpcb.com/partdetail/225410-A1257WR_S4P/C225127
Battery holder | BT1 | 1 | BS-CR2032-8 | C7498149 | SMD | Extended | No |  |  | 2026-08-15 | PCBA | セルは後付け。DR-058確認済み: pin1=-/GND、pin2=+/R4・VBAT_RTC側 | https://jlcpcb.com/partdetail/Lian_XinTechnology-BS_CR20328/C7498149
VBUS TVS | D1 | 1 | SMF6.0A | C19077499 | SOD-123FL | Extended | Yes |  |  | 2026-08-15 | PCBA | pin1(K)=VBUS_PROTECTED、pin2(A)=GND。ESD・短時間surge用でありOVPではない | https://jlcpcb.com/partdetail/hongjiacheng-SMF60A/C19077499
Status LED | D2 | 1 | KT-0603R | C2286 | 0603 | Basic | No |  |  | 2026-08-15 | PCBA | 赤色。R12=1 kOhmで電流制限 | https://jlcpcb.com/partdetail/Hubei_KENTOElec-KT0603R/C2286
Tactile switches | SW1 SW2 | 2 | TS-1088-AR02016 | C720477 | SMD 4x3mm | Basic | No |  |  | 2026-08-15 | PCBA | SW1=RESET、SW2=BOOT | https://jlcpcb.com/partdetail/XUNPU-TS_1088AR02016/C720477
CC resistors | R1 R2 | 2 | 0402WGF5101TCE | C25905 | 0402 | Basic | No |  |  | 2026-08-15 | PCBA | 5.1 kOhm / USB-C CC1/CC2 Rd | https://jlcpcb.com/partdetail/C25905
VBUS bypass jumper | R3 | 1 | 0603WAF0000T5E | C21189 | 0603 | Basic | No |  |  | 2026-08-15 | PCBA | DR-057。F1と並列。初回R3実装/F1 DNP。F1/R3同時実装禁止。R36ではない | https://jlcpcb.com/partdetail/C21189
VBAT current-limit | R4 | 1 | 0402WGF1000TCE | C25076 | 0402 | Basic | No |  |  | 2026-08-15 | PCBA | 100 Ohm。BT1とVBAT_RTCの間 | https://jlcpcb.com/partdetail/C25076
Clock bias upper | R5 | 1 | 0402WGF3302TCE | C25779 | 0402 | Basic | No |  |  | 2026-08-15 | PCBA | 33 kOhm。R6=15 kOhmと1.031 Vを生成 | https://jlcpcb.com/partdetail/C25779
Clock bias lower | R6 | 1 | 0402WGF1502TCE | C25756 | 0402 | Basic | No |  |  | 2026-08-15 | PCBA | 15 kOhm。VREF_CLK-GND | https://jlcpcb.com/partdetail/C25756
10 kOhm resistors | R7 R9 | 2 | 0402WGF1002TCE | C25744 | 0402 | Basic | No |  |  | 2026-08-15 | PCBA | R7=TCXO input bias、R9=NRST pull-up | https://jlcpcb.com/partdetail/C25744
33 Ohm series resistors | R8 R20 R22 R24-R31 | 11 | 0402WGF330JTCE | C25105 | 0402 | Basic | No |  |  | 2026-08-15 | PCBA | R8=CLK_24M、R20/R22/R24-R31=通常PPS/UART出力 | https://jlcpcb.com/partdetail/C25105
1 kOhm resistors | R10 R12 | 2 | 0402WGF1001TCE | C11702 | 0402 | Basic | No |  |  | 2026-08-15 | PCBA | R10=BOOT switch series、R12=status LED | https://jlcpcb.com/partdetail/C11702
100 kOhm pull/bias resistors | R11 R14 R15 R32-R41 | 13 | 0402WGF1003TCE | C25741 | 0402 | Basic | No |  |  | 2026-08-15 | PCBA | R11=BOOT0 pull-down、R14=GNSS PPS pull-down、R15/R39-R41=input pull-up、R32-R38=OE_N pull-up | https://jlcpcb.com/partdetail/C25741
Input series resistors | R13 R16-R19 | 5 | 0402WGF4701TCE | C25900 | 0402 | Basic | No |  |  | 2026-08-15 | PCBA | 4.7 kOhm。U4外部入力5回路 | https://jlcpcb.com/partdetail/C25900
VLP output series resistors | R21 R23 | 2 | 0402WGF100JTCE | C25077 | 0402 | Basic | No |  |  | 2026-08-15 | PCBA | 10 Ohm。VLP_PPS_OUT/VLP_TX_OUT | https://jlcpcb.com/partdetail/C25077
VBUS bulk | C1 | 1 | CL21A475KAQNNNE | C1779 | 0805 | Basic | No |  |  | 2026-08-15 | PCBA | 4.7 uF / 25 V。VBUS_PROTECTED-GND。OI-009解決 | https://jlcpcb.com/partdetail/C1779
3V3 bulk | C2 C3 | 2 | CL10A106MA8NRNC | C96446 | 0603 | Basic | No |  |  | 2026-08-15 | PCBA | 10 uF / 25 V。3V3-GND | https://jlcpcb.com/partdetail/C96446
Decoupling | C5 C6 C8 C9 C10 C12 C13 C16-C20 | 12 | CL05B104KO5NNNC | C1525 | 0402 | Basic | No |  |  | 2026-08-15 | PCBA | 100 nF。各IC/rail直近 | https://jlcpcb.com/partdetail/C1525
MCU bulk | C7 | 1 | CL05A475MP5NRNC | C23733 | 0402 | Basic | No |  |  | 2026-08-15 | PCBA | 4.7 uF。3V3-GND | https://jlcpcb.com/partdetail/C23733
TCXO AC coupling | C11 | 1 | 0402B102K500NT | C1523 | 0402 | Basic | No |  |  | 2026-08-15 | PCBA | 1 nF。U2 OUT-U14 input間 | https://jlcpcb.com/partdetail/C1523
LSE load capacitors | C14 C15 | 2 | CL05C100JB5NNNC | C32949 | 0402 | Basic | No |  |  | 2026-08-15 | PCBA | 10 pF C0G。試作でLSE margin確認 | https://jlcpcb.com/partdetail/C32949
Resettable fuse | F1 | 1 | MF-NSMF050-2 | C75464 | 1206 | Extended | No |  |  | 2026-08-15 | DNP | 初回DNP。保護variantではF1実装/R3 DNP。F1/R3同時実装禁止 | https://jlcpcb.com/partdetail/BOURNS-MF_NSMF0502/C75464
Test pads | TP1-TP9 | 9 |  | N/A | Test-pad | N/A | N/A |  |  | 2026-08-15 | PCB | TP1-TP5=SWD、TP6=PPS_GENERATED、TP7/TP8=VLP測定、TP9=firmware trace
