CoderDojoMusashikosugi/cub_2026_timing_sync_if_board/hardware/rev1/schematic_2026-09-06.pdf

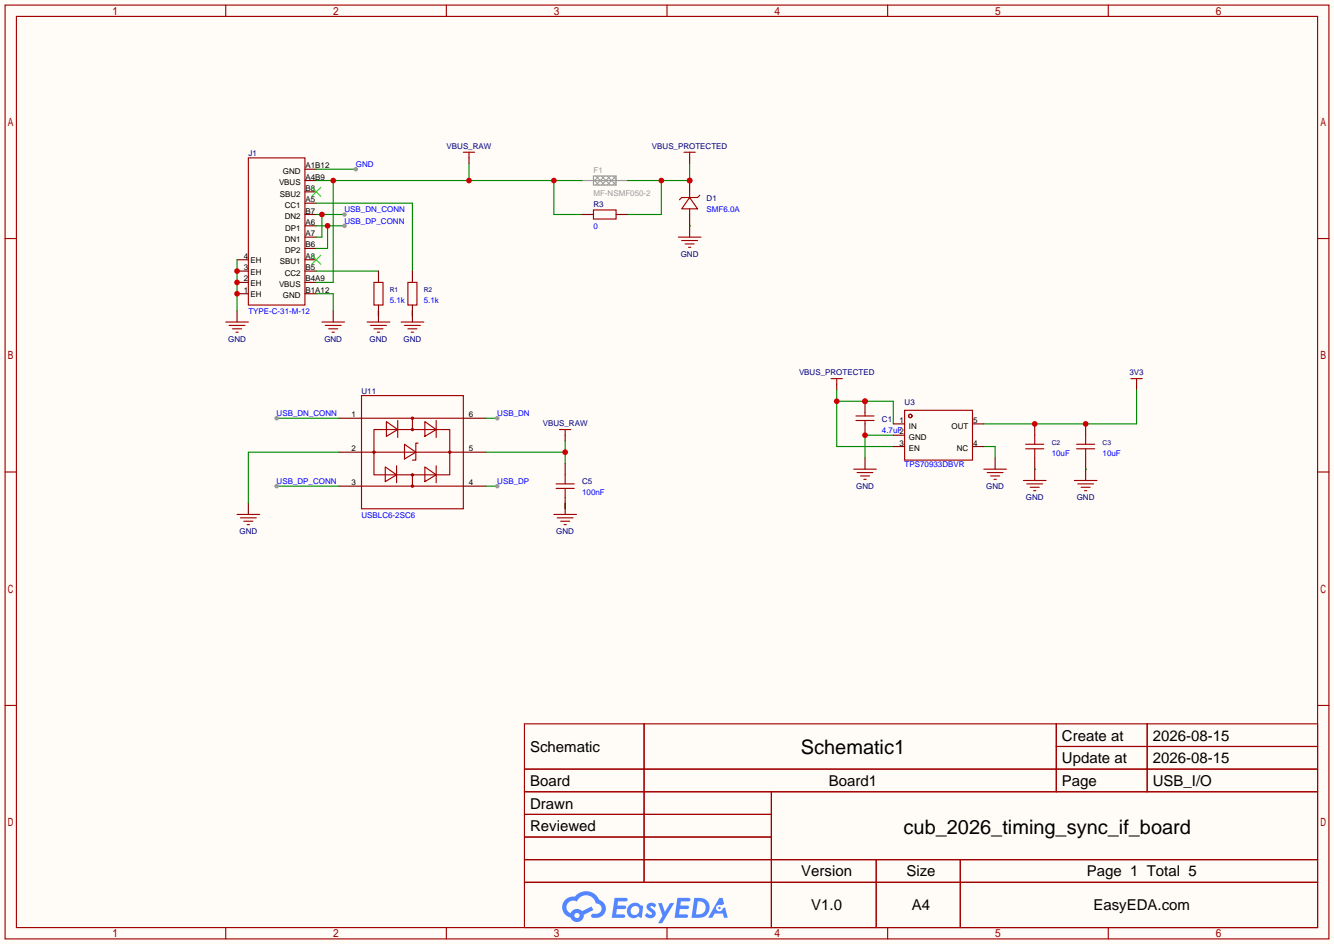
[picture p1: page 1]

Schematic | Schematic1 | Create at | 2026-08-15

Update at | 2026-08-15

Board | Board1 | Page | USB_I/O
Drawn | | cub_2026_timing_sync_if_board
Reviewed

Version | Size | Page 1 Total 5
V1.0 | A4 | EasyEDA.com

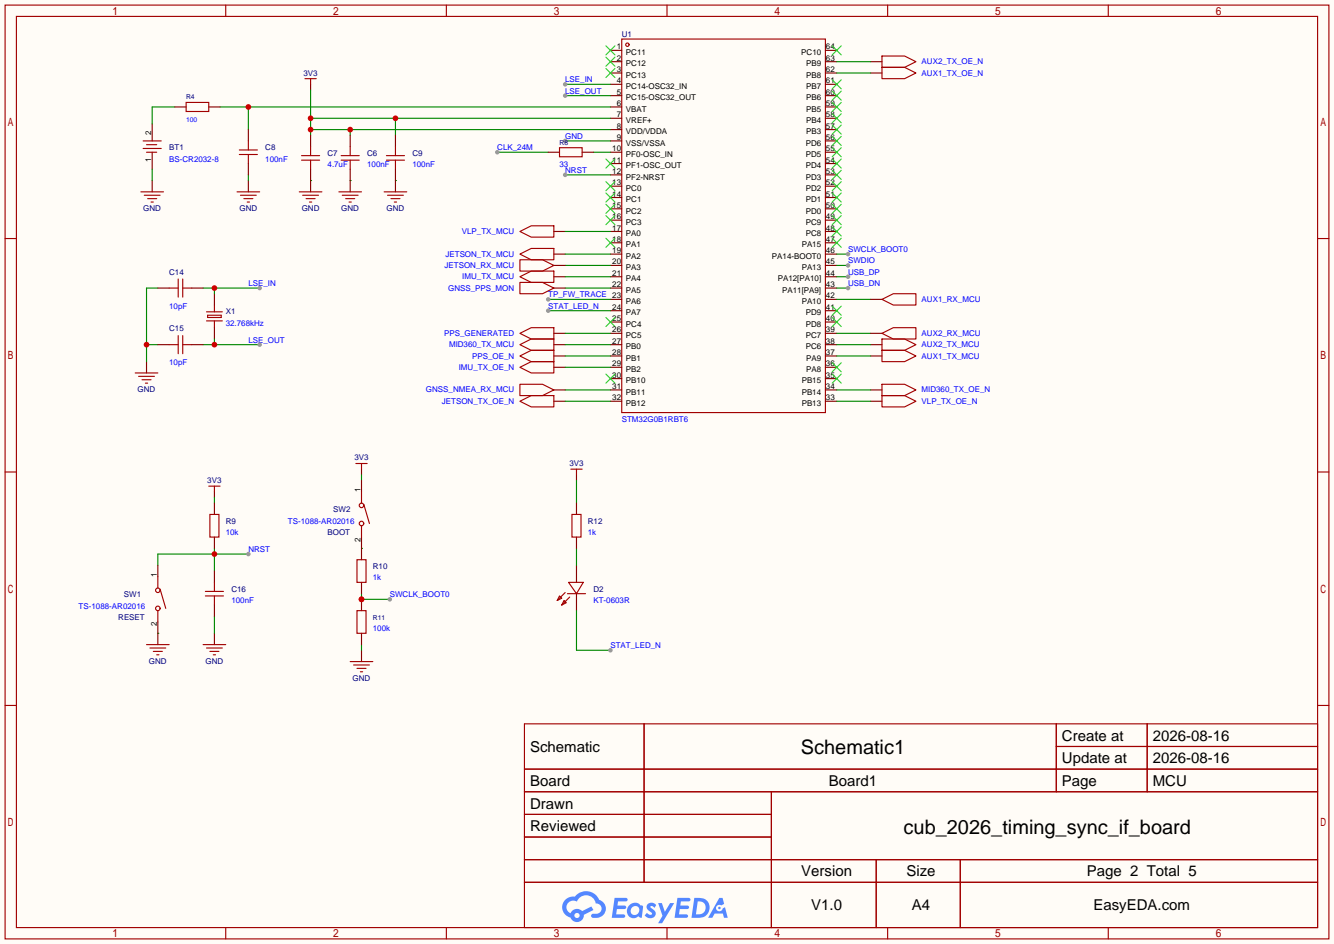
[picture p2: page 2]

Schematic | Schematic1 | Create at | 2026-08-16

Update at | 2026-08-16

Board | Board1 | Page | MCU
Drawn | | cub_2026_timing_sync_if_board
Reviewed

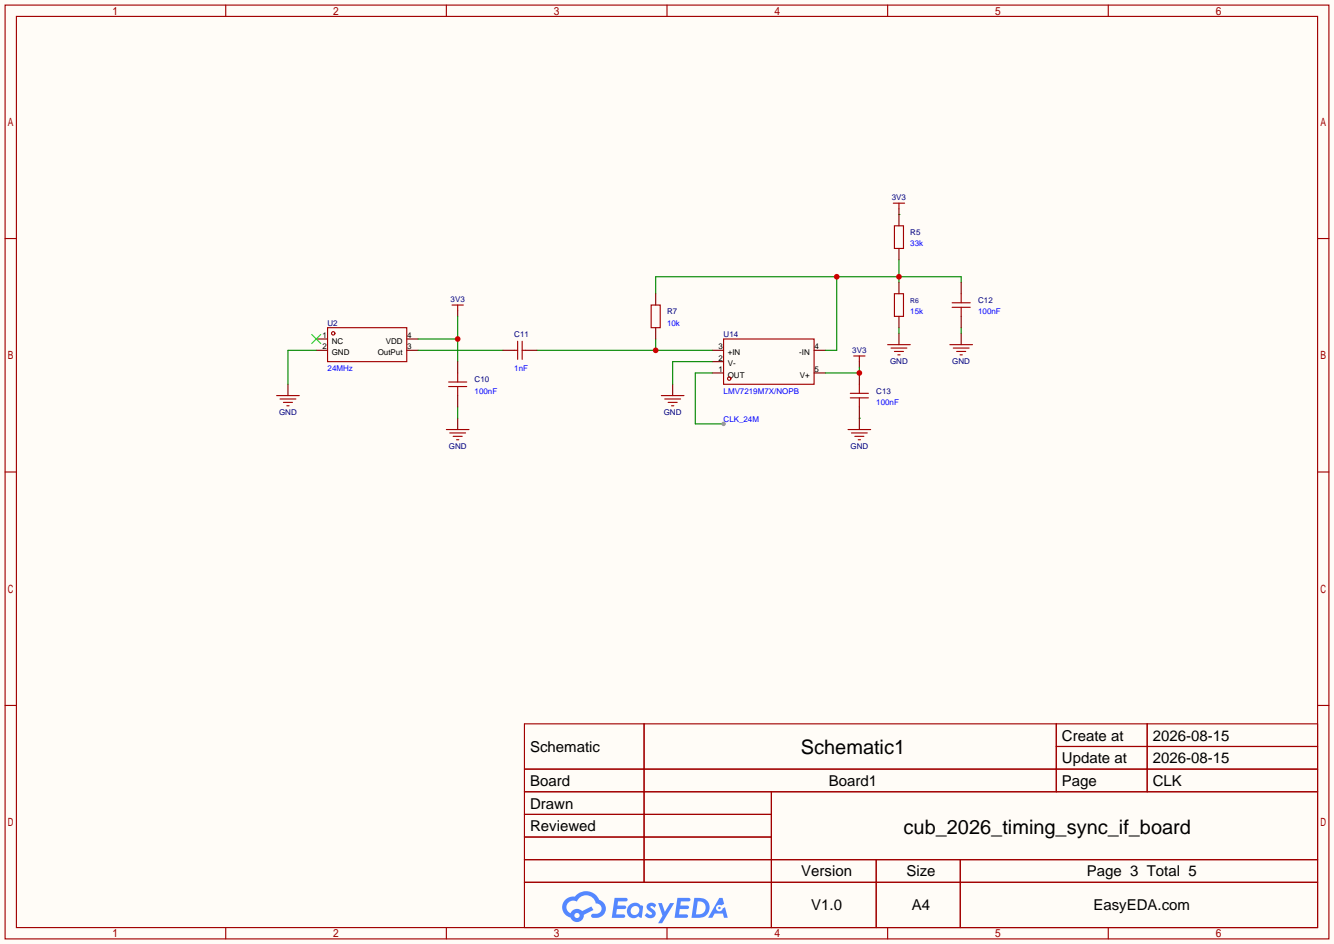
[picture p3: page 3]

Schematic | Schematic1 | Create at | 2026-08-15

Update at | 2026-08-15

Board | Board1 | Page | CLK
Drawn | | cub_2026_timing_sync_if_board
Reviewed

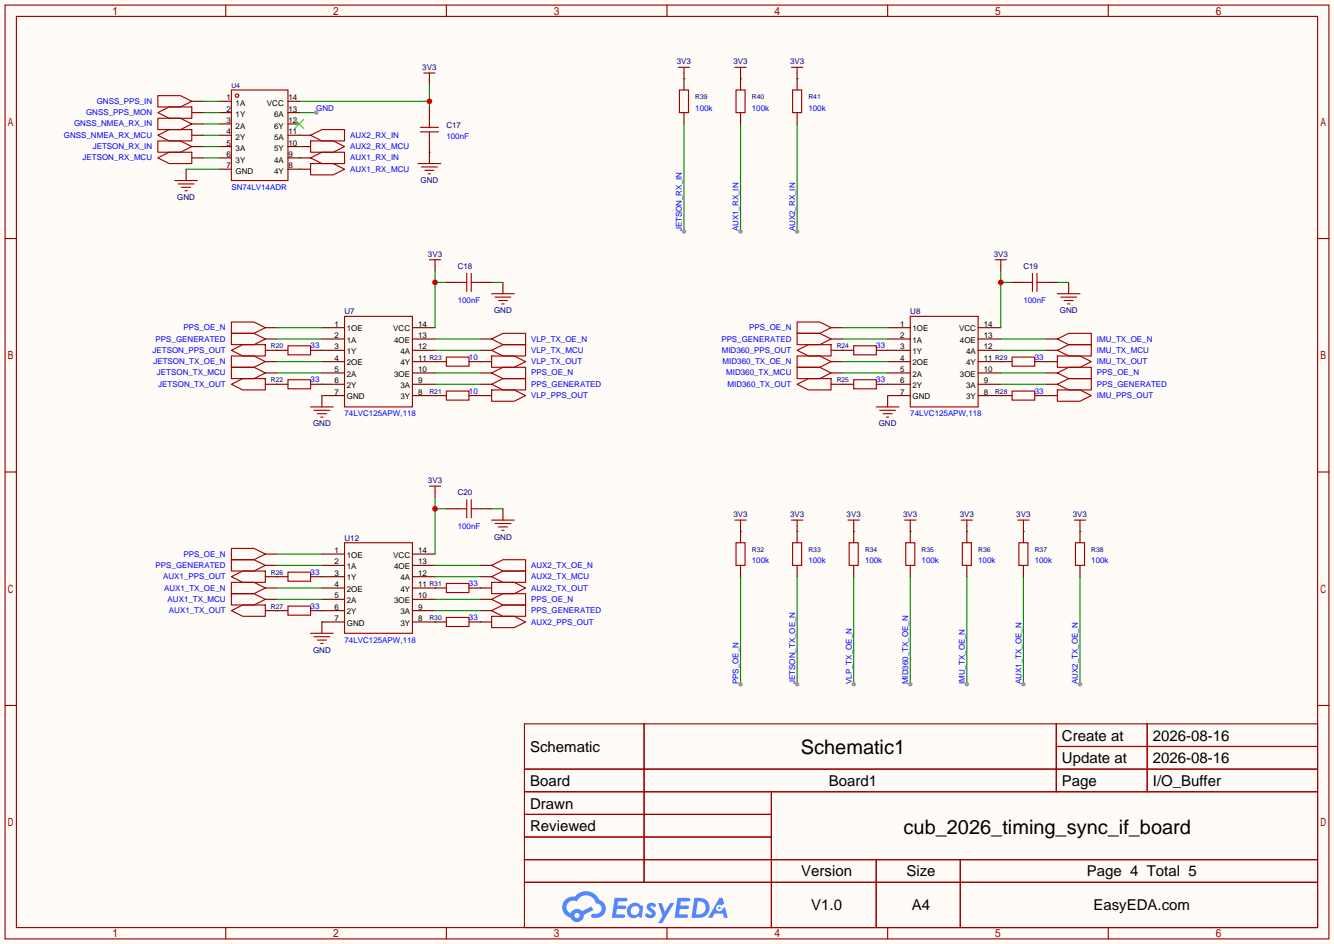
[picture p4: page 4]

Schematic | Schematic1 | Create at | 2026-08-16

Update at | 2026-08-16

Board | Board1 | Page | I/O_Buffer
Drawn | | cub_2026_timing_sync_if_board
Reviewed

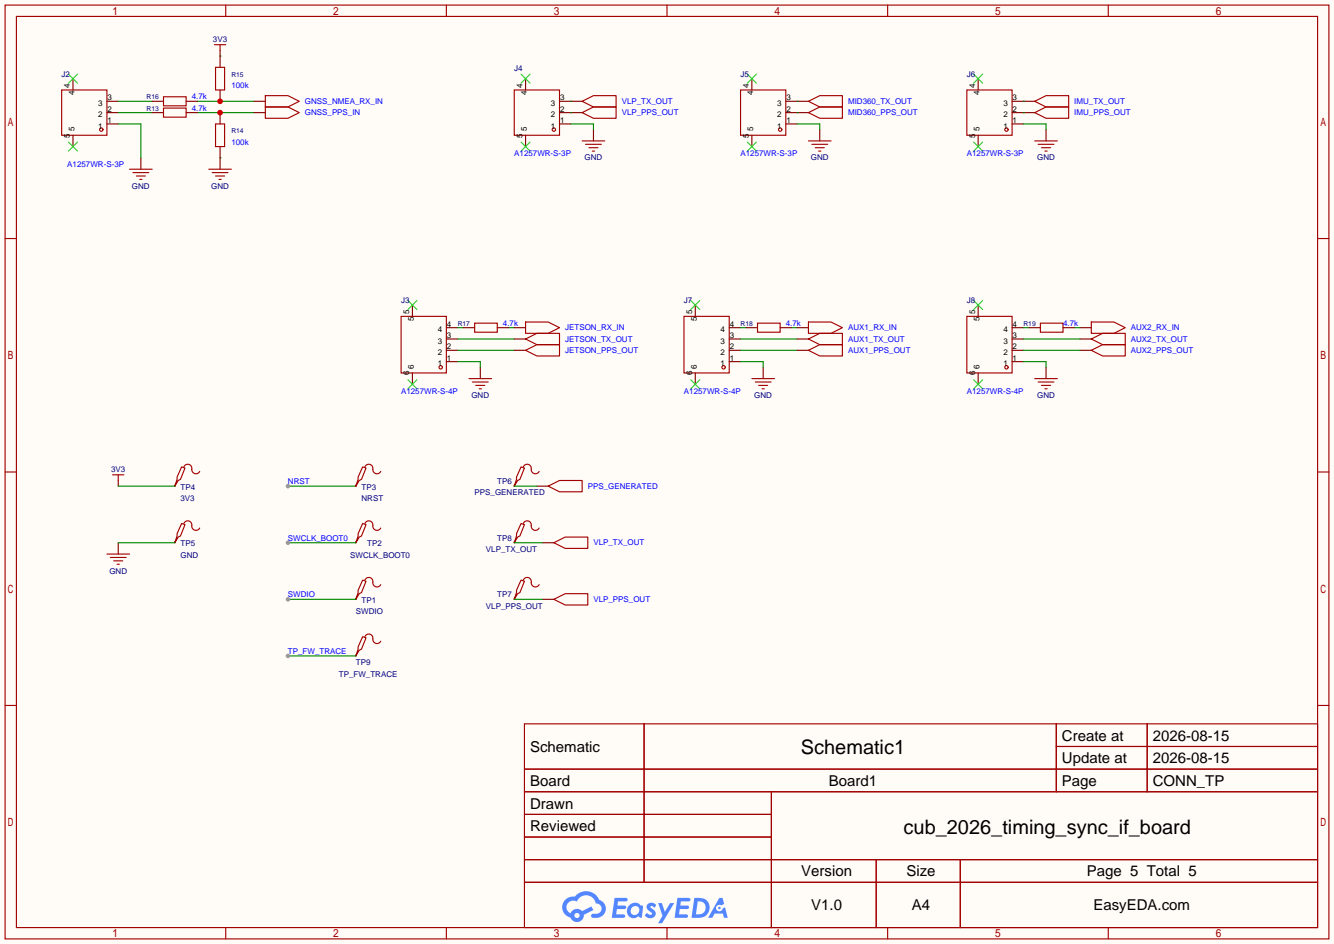
[picture p5: page 5]

Schematic | Schematic1 | Create at | 2026-08-15

Update at | 2026-08-15

Board | Board1 | Page | CONN_TP
Drawn | | cub_2026_timing_sync_if_board
Reviewed
