CoderDojoMusashikosugi/cub_2026_timing_sync_if_board/hardware/rev1/pcb_2026-09-06.pdf

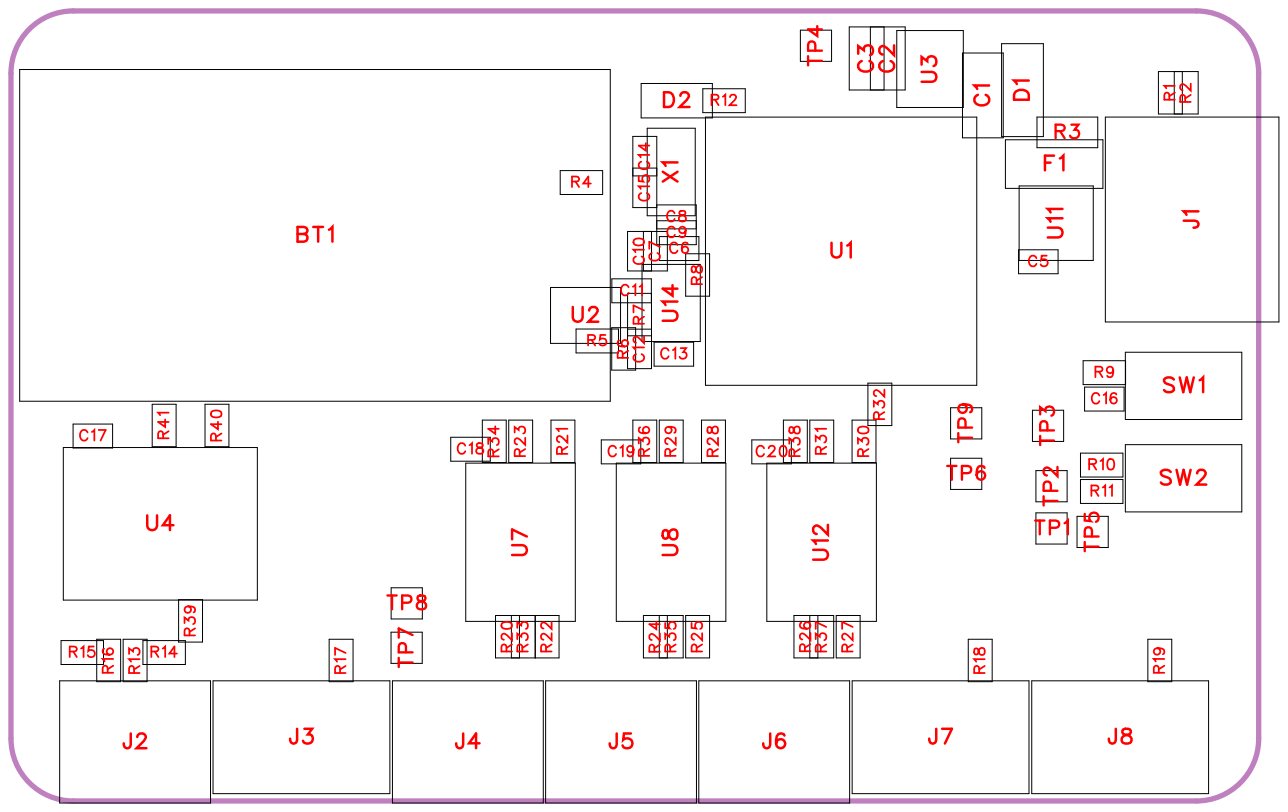
[picture p6: page 1]

No. | Quantity | Comment | Designator | Footprint | Value | Manufacturer Part | Manufacturer | Supplier Part | Supplier
1 | 1 | BS-CR2032-8 | BT1 | BAT-SMD_B S-CR2032-8 | | BS-CR2032-8 | LX(连欣科技) | C7498149 | LCSC
2 | 1 | 4.7uF | C1 | C0805 | 4.7uF | CL21A475KA QNNNE | SAMSUNG( 三星) | C1779 | LCSC
3 | 2 | 10uF | C2,C3 | C0603 | 10uF | CL10A106M A8NRNC | SAMSUNG( 三星) | C96446 | LCSC
4 | 12 | 100nF | C5,C6,C8,C9,C10,C12,C13, C16,C17,C18,C19,C20 | C0402 | 100nF | CL05B104K O5NNNC | SAMSUNG( 三星) | C1525 | LCSC
5 | 1 | 4.7uF | C7 | C0402 | 4.7uF | CL05A475M P5NRNC | SAMSUNG( 三星) | C23733 | LCSC
6 | 1 | 1nF | C11 | C0402 | 1nF | 0402B102K5 00NT | FH(风华) | C1523 | LCSC
7 | 2 | 10pF | C14,C15 | C0402 | 10pF | CL05C100JB 5NNNC | SAMSUNG( 三星) | C32949 | LCSC
8 | 1 | SMF6.0A | D1 | SOD-123FL_ L2.7-W1.8-L S3.8-RD | | SMF6.0A | R+O(宏嘉诚) | C19077499 | LCSC
9 | 1 | KT-0603R | D2 | LED-SMD_L 1.6-W0.8-R-RD | | KT-0603R | KENTO | C2286 | LCSC
10 | 1 | TYPE-C-31-M-12 | J1 | USB-C_SMD -TYPE-C-31-M-12_1 | | TYPE-C-31-M-12 | 韩国韩荣 | C165948 | LCSC
11 | 4 | A1257WR-S-3P | J2,J4,J5,J6 | CONN-SMD_ A1257WR-S-3P | | A1257WR-S-3P | CJT(长江连 接器) | C225126 | LCSC
12 | 3 | A1257WR-S-4P | J3,J7,J8 | CONN-SMD_ 4P-A1257W R-S-4P | | A1257WR-S-4P | CJT(长江连 接器) | C225127 | LCSC
13 | 2 | 5.1k | R1,R2 | R0402 | 5.1k | 0402WGF51 01TCE | UNI-ROYAL( 厚声) | C25905 | LCSC
14 | 1 | 0 | R3 | R0603 | 0 | 0603WAF00 00T5E | UNI-ROYAL( 厚声) | C21189 | LCSC
15 | 1 | 100 | R4 | R0402 | 100 | 0402WGF10 00TCE | UNI-ROYAL( 厚声) | C25076 | LCSC
16 | 1 | 33k | R5 | R0402 | 33k | 0402WGF33 02TCE | UNI-ROYAL( 厚声) | C25779 | LCSC
17 | 1 | 15k | R6 | R0402 | 15k | 0402WGF15 02TCE | UNI-ROYAL( 厚声) | C25756 | LCSC
18 | 2 | 10k | R7,R9 | R0402 | 10k | 0402WGF10 02TCE | UNI-ROYAL( 厚声) | C25744 | LCSC
19 | 11 | 33 | R8,R20,R22,R24,R25,R26, R27,R28,R29,R30,R31 | R0402 | 33 | 0402WGF33 0JTCE | UNI-ROYAL( 厚声) | C25105 | LCSC
20 | 2 | 1k | R10,R12 | R0402 | 1k | 0402WGF10 01TCE | UNI-ROYAL( 厚声) | C11702 | LCSC
21 | 13 | 100k | R11,R14,R15,R32,R33,R34 ,R35,R36,R37,R38,R39,R4 0,R41 | R0402 | 100k | 0402WGF10 03TCE | UNI-ROYAL( 厚声) | C25741 | LCSC

22 | 5 | 4.7k | R13,R16,R17,R18,R19 | R0402 | 4.7k | 0402WGF47 01TCE | UNI-ROYAL( 厚声 ) | C25900 | LCSC
23 | 2 | 10 | R21,R23 | R0402 | 10 | 0402WGF10 0JTCE | UNI-ROYAL( ) 厚声 | C25077 | LCSC
24 | 2 | TS-1088-AR 02016 | SW1,SW2 | SW-SMD_L3 .9-W3.0-P4.4 5 | | TS-1088-AR 02016 | XUNPU(讯普 ) | C720477 | LCSC
25 | 9 | Test-Point | TP1,TP2,TP3,TP4,TP5,TP6 ,TP7,TP8,TP9 | Test-Point-0. 5mm
26 | 1 | STM32G0B1 RBT6 | U1 | LQFP-64_L1 0.0-W10.0-P 0.50-LS12.0-BL | | STM32G0B1 RBT6 | ST(意法半导 体) | C5143679 | LCSC
27 | 1 | 24MHz | U2 | OSC-SMD_4 P-L2.0-W1.6-BL_TXC_7Z | 24MHz | OW7EL89CE NUYO3YLC-24M | YXC(扬兴晶 振) | C22434890 | LCSC
28 | 1 | TPS70933D BVR | U3 | SOT-23-5_L3 .0-W1.7-P0.9 5-LS2.8-BR | | TPS70933D BVR | TI(德州仪器 ) | C89347 | LCSC
29 | 1 | SN74LV14A DR | U4 | SOIC-14_L8. 7-W3.9-P1.2 7-LS6.0-BL | | SN74LV14A DR | TI(德州仪器 ) | C475503 | LCSC
30 | 3 | 74LVC125AP W,118 | U7,U8,U12 | TSSOP-14_L 5.0-W4.4-P0. 65-LS6.4-BL | | 74LVC125AP W,118 | Nexperia( 安 世 ) | C6059 | LCSC
31 | 1 | USBLC6-2S C6 | U11 | SOT-23-6_L2 .9-W1.6-P0.9 5-LS2.8-BL | | USBLC6-2S C6 | ST(意法半导 体) | C7519 | LCSC
32 | 1 | LMV7219M7 X/NOPB | U14 | SC-70-5_L2. 1-W1.3-P0.6 5-LS2.2-BR | | LMV7219M7 X/NOPB | TI(德州仪器 ) | C544337 | LCSC
33 | 1 | 32.768kHz | X1 | OSC-SMD_L 3.2-W1.5 | 32.768kHz | SC-32S32.76 8kHz20PPM 7pF | Seiko(精工 ) | C97604 | LCSC

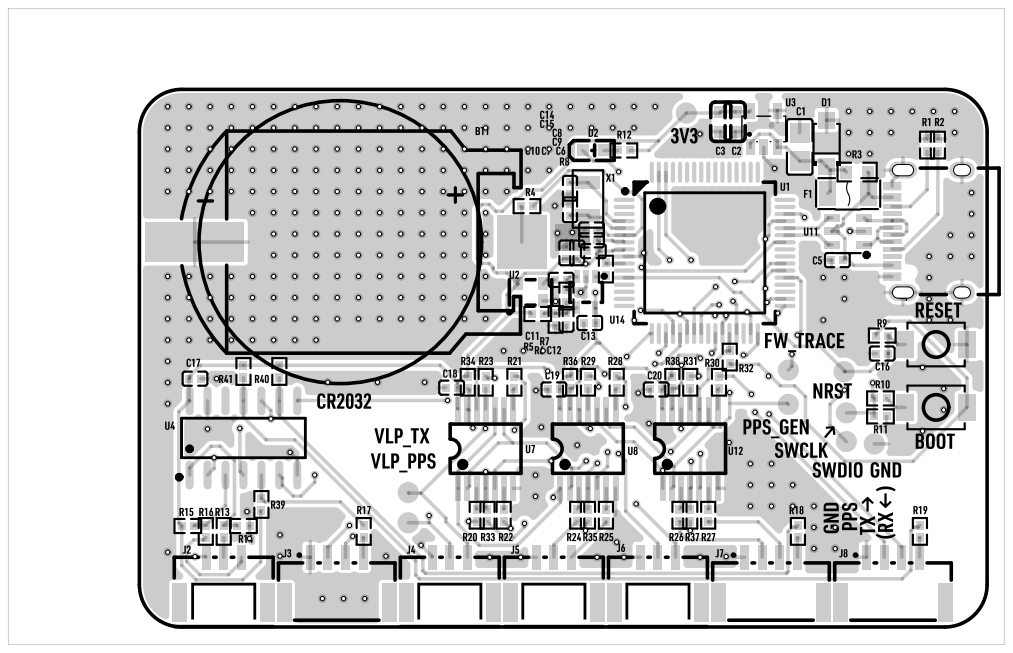
[picture p7: page 5]

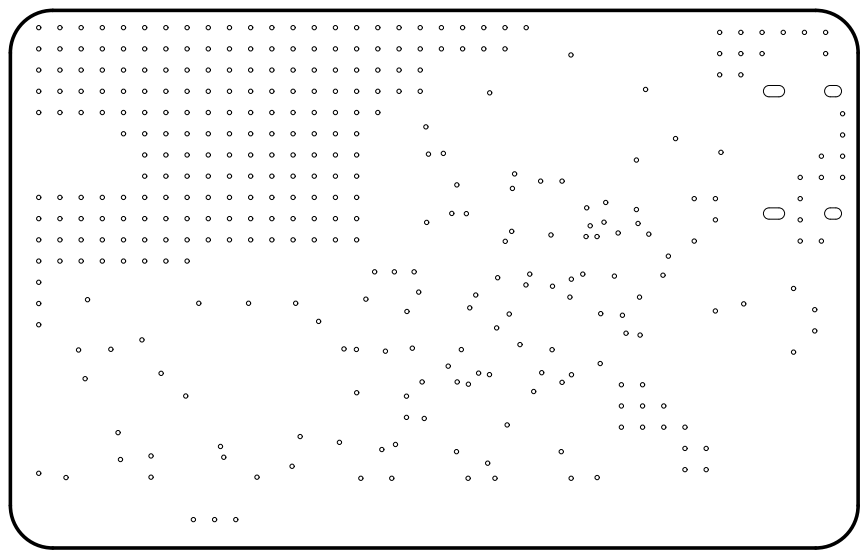
[picture p8: page 6]

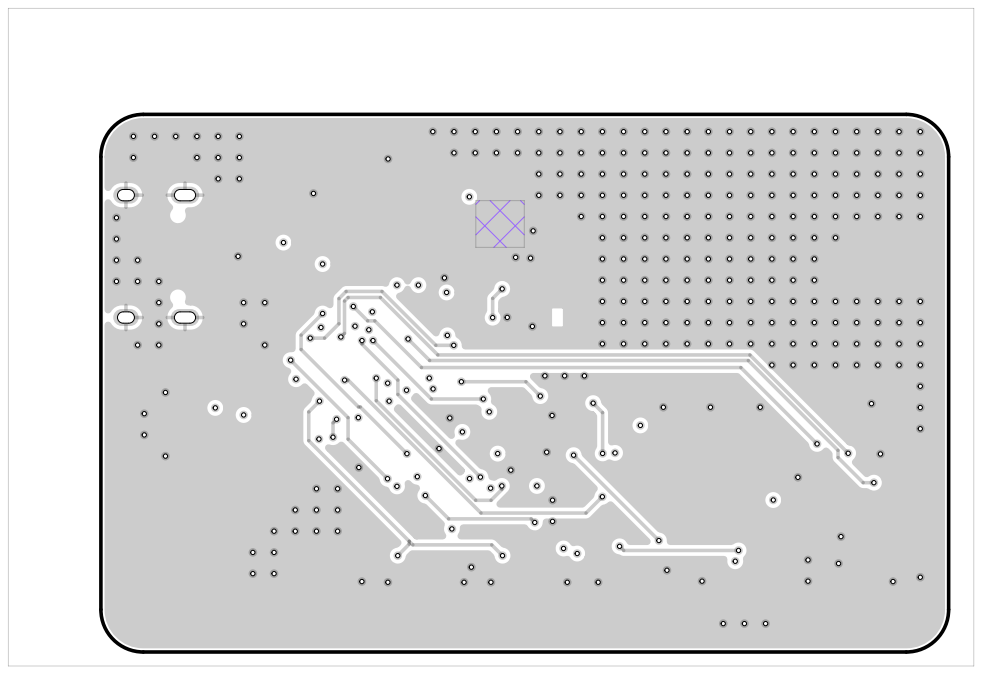
[picture p9: page 8]
