CoderDojoMusashikosugi/cub_2026_timing_sync_if_board/(commit log)

2026-08-11 ドキュメント整理
    [bom_preliminary.csv]
2026-08-11 ドキュメントのレビュークリア
    [bom_preliminary.csv]
2026-08-12 DS3231削除
    [bom_preliminary.csv]
2026-08-12 Codexレビュー
2026-08-12 オシレーター変更
    [bom_preliminary.csv]
2026-08-14 refsch/schematic_ref のネットリストデータを統合、ツール名でリネーム
    - hardware/ref_common/netlist_data.py を新設し、refsch(Lcapy)と
    schematic_ref(Schemdraw)が別々に持っていた netlist_data.py を1本化。
    COMPONENTS/NETS/OPEN_ITEMS (旧 DISCREPANCIES + OPEN_POINTS を統合、
    RD-01〜RD-12) の唯一のデータ源とした。
    - hardware/refsch/ -> hardware/refsch_lcapy/、
    hardware/schematic_ref/ -> hardware/refsch_schemdraw/ にリネーム。
    ツールごとの描画・表生成スクリプトのみを残し、両方とも
    ref_common/netlist_data.py を import する。
    - データの内容は基本的に旧refsch側の判断を採用。J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
2026-08-14 SCH作成完了
    [bom_preliminary.csv]
2026-08-15 レビュー後修正
    [bom_preliminary.csv]
2026-09-06 発注済み
    [bom_preliminary.csv]
2026-10-03 テストFW
2026-10-10 feat(firmware): GNSS同期の製品firmware（app image）を追加
    bring-upとselftestだけだったfirmwareに、GNSSで規律したPPSとGPRMCを
    J3～J8へ出す製品firmwareを加える。Jetsonとの双方向通信はUSB CDCの
    2つ目のinterfaceへ移す（DR-061）。
    - app image（FW_APP）
    - timesync.c: TIM2の生成PPSをGNSS PPSへ規律し、lock・holdover・
    FAULTの状態遷移と出力enableを行う。未決定のP項目は冒頭の暫定値
    - dpll.c: 周期長（ARR）だけで位相と周波数を合わせる制御則
    - rtc_keep.c: 内蔵RTCとbackup registerで時刻を保持し、起動時に
    backup domainを検証する
    - jetson_usb.c: Jetson protoc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
2026-10-10 fix(firmware): USB電源を切るとRTCの時刻が消える不具合を修正
    TAMP_CR1の初期値（0xFFFF0000）では内部tamper 3～6が有効で、
    ITAMP4（HSE monitoring）はHSE CSSの検出でbackup registerを消す。
    USBを抜くと3V3が下がる途中でMCUより先にTCXOが止まるため、電源を
    切るたびにbackupが消え、次の起動の検証がBDRSTして、電池で残って
    いたcalendarも失っていた（2台目の基板 UID …000E0038で実測）。
    - rtc_keep.c: 起動時の検証の後、毎回ITAMP4Eを0にしてITAMP4Fを消す
    - 起動時の検証前にTAMP_SR・TAMP_CR1・calendarを記録し、statusに出す
    - regsの監査にTAMP_CR1.ITAMP4E=0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
2026-10-10 docs: Jetsonへの配線を中継基板の範囲とする（DR-062）
    J3は別の中継基板へGHケーブルでつなぎ、Jetson 40-pin headerのどのpinへ
    つなぐかは中継基板で管理する。設計書とハーネス表からheader pinの割当
    （pin 7=PPS、pin 8/10=UART）を削除した。
    あわせて、DR-061（Jetsonとの通信をUSB CDCへ移し、J3を出力専用にする）が
    未反映だった設計書、Jetson protocol仕様の目的、試験計画（T-04、SY-01、
    試験構成）を更新した。
2026-10-10 fix(firmware): 出力のenable・High-Zの切替を秒内150 msに揃える
    これまでHigh-Zは要求した時点ですぐに行っていたため、PPSのパルスやNMEAの
    文を途中で切ることがあった。enableと同じく、PPSがLowでNMEAを送る前の
    秒内150 ms（TIM2 CH4の割込み）でだけ切り替える。High-Zを決めた後は新しい
    NMEAを送らない。enableした秒はその秒境界のPPSが出ていないので、次のPPSの
    時刻を送るJ4（VLP）の文だけ送る。
    High-Zは最大約1.15秒遅れるが、stepで動く秒境界はARRのpreloadにより早くても
    3周期先なので、それより前に完了する。状態遷移の文書に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
2026-10-10 fix(firmware): UM982とのGNSS同期で見つかった不具合を直し、受信のdebug表示を加える
    屋外でUM982とつないで初めてlockさせた試験で見つかった3件を直した。
    - UM982は緯度経度を分の小数8桁で出すため、測位後のRMCが規格の80文字を
    超えて（83文字前後）受信時に捨てられ、lockできなかった。受信は120文字まで
    受け付け、出力のRMCは緯度経度を小数5桁に切り捨てて82文字に収める
    - TCXO偏差F（count/秒、Q16）をppbへ直す式が1000倍ずれていた。表示だけで
    なくRTCのsmooth calibrationにも使っており、lockの約5分後に誤った補正
    （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
    [gnss_watch.py]
2026-10-10 docs: 2026-10-10の実機試験の記録とopen issuesを更新する
    基板 …000E0038 の試験記録に、GNSS関係の結果を加えた。J2の無反応はハーネスの
    UM982側でTXとRXを取り違えていたためで、直した後はUM982のCOM3（115200）から
    受信できた。屋外ではPPSとRMC=Aがそろってから8秒でGNSS_LOCKEDになり、lock中
    175秒の位相差はσ 20 ns、最大62 ns。gnss_watch.pyの記録3本を添える。
    open issuesでは、OI-017（UM982からJ2へ信号が来ない）を解決済みへ移し、
    基板のUSBが列挙されたまま応答しなくなった件をOI-018として加えた。発注後の
    状態に合わせて、OI-014/OI-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
2026-10-16 fix: EasyEDAのPDFを改行変換しないようにする
    EasyEDAが出力するPDFは文字だけで書かれているため、gitがtextと判定して
    いた。Windowsのcore.autocrlf=trueではcheckout時にCRが入り、PDF内部の
    offset（xref）がずれた壊れたファイルになっていた（repo内のblobは元の
    ままで正しい）。*.pdfをbinaryとして扱い、変換しないようにする。
    既にcheckout済みの作業コピーは自動では直らない。直すには、そのPDFを
    消してgit checkoutし直す。
2026-10-16 docs: 設計文書を発注版の基板と現在のfirmwareに合わせる
    公開に向けて、発注版（pcb_review/round3のEasyEDA出力）とfirmwareのsource
    を文書と照合し、読者が誤解する記述を直した。回路の接続（MCU全pin、J2～J8、
    出力buffer、bias）は一致していた。
    基板:
    - 発注版は60 x 38 mm・4層・TPは表面・取付穴なしで、設計書の当初値
    （75 x 50 mm・2層・TPは裏面）と違うことを設計書に書いた。D1（TVS）は
    実装済み、USBに直列抵抗はない、LSE周りのローカルGNDとguard ringは
    作っていない、なども反映した
    - option byteが出荷時のままで、SW2+SW1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
    [bom_2026-09-06.csv, bom_preliminary.csv]
2026-10-16 feat: 設計情報とfirmwareを公開リポジトリへ写す仕組みを加える
    チームが参照できるよう、回路の設計情報とfirmwareだけをCoderDojoMusashikosugi
    の公開リポジトリへ写す。このリポジトリは非公開のまま正本として使い続ける。
    - tools/public_paths.txtに公開する範囲を書く。レビュー記録、データシート、
    試験ログ、検討記録、回路図作成ツール、レイアウト前の指針は含めない
    - tools/publish_public.pyは、mainをcloneしてgit-filter-repoで範囲だけを
    履歴ごと残し、作者のe-mailをGitHubのnoreplyへ置き換えてpushする。既定は
    pushしない試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
2026-10-17 docs: LICENSEをMITの本文だけにする
    MITの本文の後ろにfirmware/third_party/の説明を足していたため、GitHubが
    ライセンスをMITと判定できなかった（NOASSERTION）。第三者sourceの
    ライセンスの説明はREADME.mdに既にあるので、LICENSEからは削る。
